ArthurBondar/Tow-Camera-Public/Documentation/Instructions/Images/assembly 2.PNG

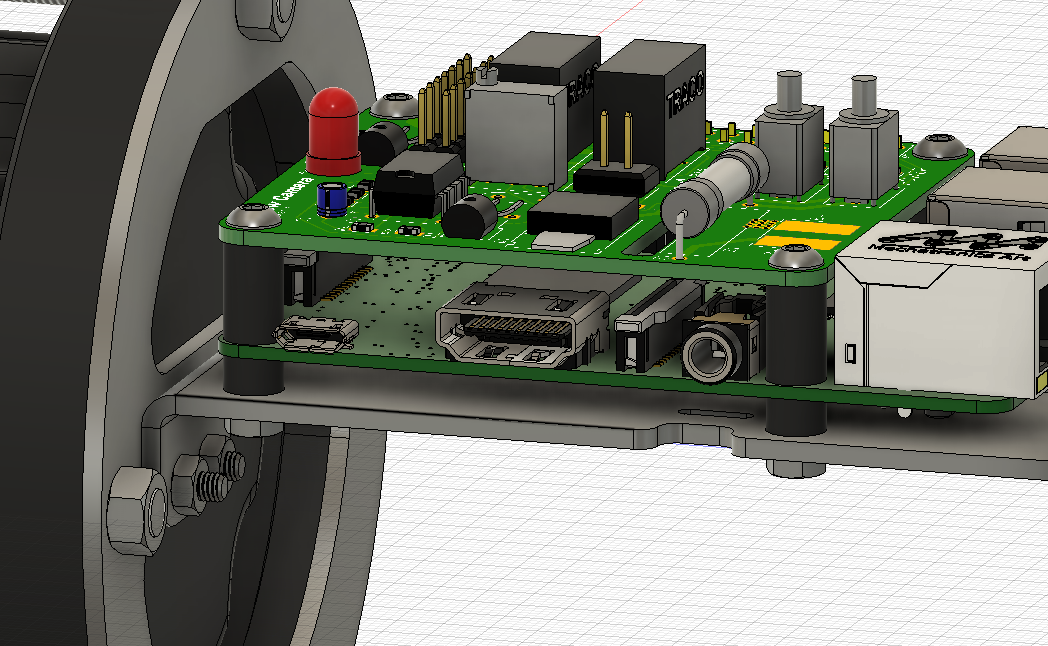
Documentation/Instructions/Images/assembly 2.PNG
