ArthurBondar/Tow-Camera-Public/Documentation/Instructions/Images/dissasembly 2.PNG

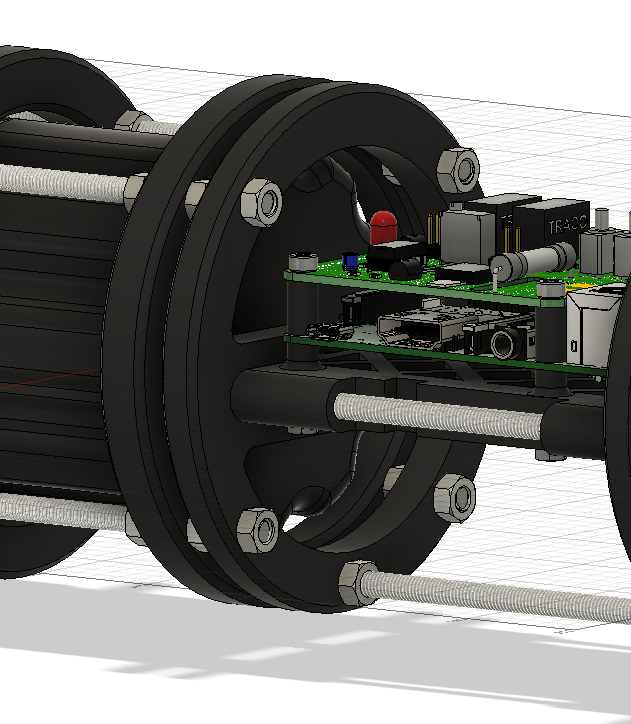
Documentation/Instructions/Images/dissasembly 2.PNG
