ArthurBondar/Tow-Camera-Public/Software/docs/raspbian - How can I prevent my Pi's SD card from getting corrupted so often_ - Raspberry Pi Stack Exchange.pdf

Raspberry Pi Stack Exchange is a question and answer site for users and developers of hardware and software for Raspberry Pi. It only takes a minute to sign up.

Sign up to join this community (https://raspberrypi.stackexchange.com/users/signup?ssrc=hero)

Anybody can ask a question

Anybody can answer

The best answers are voted up and rise to the top

How can I prevent my Pi's SD card from getting corrupted so often? (https://raspberrypi.stackexchange.com/questions/7978/how-can-i-prevent-my-pis-sd-card-from-getting-corrupted-so-often)

Asked 6 years, 11 months ago Active 1 month ago (https://raspberrypi.stackexchange.com/questions/7978/how-can-i-prevent-my-pis-sd-card-from-getting-corrupted-so-often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) Viewed 65k times

48

37

I get an I/O error at boot and then get this 'error': (I am running the latest version of Raspbian)

Entering kdb (current=0xca82ac80, pid 1) due to keyboard entry
kdb> _

And I have seen it before, and was explained that my SD card got corrupted since I did not shutdown correctly. One week later, I didn't deal with this error, until the power flickered on/off thrice and now I can't boot again. It seems like I am re-preparing my SD card ever day!!! I don't like this, not to mention I love my Pi's capabilities. But this 'breakpoint' is driving me crazy! Is there some way I can prevent this or strengthen something so it doesn't happen if the power goes out? Any suggestions? Thanks!

P.S. My zip file was not corrupted and my extraction service is Win32DiskImager

raspbian (https://raspberrypi.stackexchange.com/questions/tagged/raspbian) | sd-card (https://raspberrypi.stackexchange.com/questions/tagged/sd-card) | boot-issues (https://raspberrypi.stackexchange.com/questions/tagged/boot-issues)
edited Jun 16 '13 at 17:28 (https://raspberrypi.stackexchange.com/posts/7978/revisions) | asked Jun 15 '13 at 1:43
user151324 (https://raspberrypi.stackexchange.com/users/7839/user151324)
1,090 | 4 | 13 | 17

2 Is your card on this list (http://elinux.org/RPi_SD_cards) – Butters (https://raspberrypi.stackexchange.com/users/7155/butters) Jun 15 '13 at 2:05

have you ever thought about UPS ? – lenik (https://raspberrypi.stackexchange.com/users/7274/lenik) Jun 15 '13 at 7:29

@lenik Are you saying I should have something like a surge protector? – (https://stackoverflow.com/legal/cookie-policy) user151324 (https://raspberrypi.stackexchange.com/users/7839/user151324) Jun 15 (https://stackoverflow.com/legal/privacy-policy) '13 at 13:53 (https://stackoverflow.com/legal/terms-of-service/public)

By using our site, you acknowledge that you have read and understand our | , (https://raspberrypi.stackexchange.com/users/7839/user151324) | , and
our | .

Cookie P (https://stackoverflow.com/legal/cookie-policy)olicy Privacy (https://raspberrypi.stackexchange.com/users/7839/user151324) Policy (https://stackoverflow.com/legal/privacy-policy) Terms of Service (https://stackoverflow.com/legal/terms-of-service/public)

Because you power off the thing without a proper shutdown? – jippie (https://raspberrypi.stackexchange.com/users/7987/jippie) Jun 15 '13 at 15:13

2

–

@coding_corgi more likely something with a battery inside, that provides power for 5-10 minutes after the power outage, that allows you to ignore short power flicks and gives you time to shutdown (automatically?) your computer when power goes down for a long time. It's called "Uninterruptable Power Supply" or UPS for short. lenik (https://raspberrypi.stackexchange.com/users/7274/lenik) Jun 15 '13 at 23:52

11 Answers | Active (https://raspberrypi.stackexchange.com/questions/7978/how-can-i-prevent-my-pis-sd-card-from-getting-corrupted-so-often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) | Oldest (https://raspberrypi.stackexchange.com/questions/7978/how-can-i-prevent-my-pis-sd-card-from-getting-corrupted-so-often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)

49

+50

I'm not going to write about checking your HW and compatible SD card lists, because you most probably have already checked all these. What I'm about to write is the permanent solution, that allows to nip the problem in the bud, and permanently fix the issue.

If you don't want your SD card to get broken when you flip the power switch, you have to use it in a read-only mode. If there's nothing being written to your SD card, it won't get damaged no matter what you do.

Obvious (but non-working) solution would be an attempt to flip "read-only" switch on the side of the SD card, unfortunately this does not work because the schematics shows this switch is routed nowhere and its position is generally ignored.

Another, more subtle (but working) approach would be modifying your | to mount all
your partitions read-only. The drawback of this approach is your logs have to be written somewhere else (USB stick, RAM drive?) and in case of RAM drive the logs won't persist during reboot. To do this:

/etc/fstab

1. Copy an RPi image to your SD card using any method you like.
2. Boot from SD and | will start automatically. Do not "Expand filesystem", just
set up your time zone and international settings.
| raspi-config
3. Run | , press 'p' to print the current partition table. Then enter the
following commands:

sudo fdisk /dev/mmcblk0

n | Create a new partition
[enter] Make a primary partition
[enter] Use the default number
[#] 1 greater than the end of mmcblk0p2 [enter] Expand to the end of the SD card
w | Write the partition table and exit
4. Edit | /etc/fstab | . It should look something like the following:
proc | /proc | proc | defaults 0 0
/dev/mmcblk0p1 /boot | vfat | ro | 0 0
/dev/mmcblk0p2 / | ext4 | ro | 0 0
/dev/mmcblk0p3 /home | ext4 | defaults,errors=remount-ro 0 1
none | /var/run ramfs | size=1M 0 0
none | /var/log ramfs | size=1M 0 0
5. Run | sudo partprobe | to recognize the new partition.
6. Format your new partition with | sudo mkfs --type ext4 /dev/mmcblk0p3 | .
7. Reboot.

If for some reason you need to make changes to your system, you can remount the read-only partitions with write access:

Votes (https://raspberrypi.stackexchange.com/questions/7978/how-can-i-prevent-my-pis-sd-card-from-getting-corrupted-so-often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)

sudo mount -o remount,rw /dev/mmcblk0p2

edited Mar 19 '14 at 22:33 (https://raspberrypi.stackexchange.com/posts/8038/revisions) Brad (https://raspberrypi.stackexchange.com/users/3320/brad)
107 4

answered Jun 19 '13 at 0:57 lenik (https://raspberrypi.stackexchange.com/users/7274/lenik)
11.1k | 1 | 27 | 36

Wait, I can't write to my SD card if I do this? Or only at boot? – user151324 (https://raspberrypi.stackexchange.com/users/7839/user151324) Jun 19 '13 at 2:02

1 @coding_corgi This should stop writing to the SD card entirely. – apnorton (https://raspberrypi.stackexchange.com/users/7482/apnorton) Jun 19 '13 at 2:04

–

why do you need to write to your SD card? writing to SD + power down = FS corruption, you may use USB stick or create a separate partition on SD card if you need to save some data. in this case at least your system will get up and running, and then you may check your data for possible corruption. lenik (https://raspberrypi.stackexchange.com/users/7274/lenik) Jun 19 '13 at 2:06

–

@anorton this stops write access to the first two partitions on SD card, but nobody says you cannot create another partition, or use different media to save the data. for example, read-only RasPi writing data over the network -- could be a very reliable solution. lenik (https://raspberrypi.stackexchange.com/users/7274/lenik) Jun 19 '13 at 2:07

1

–

I write to my SD card video data from raspi cam and it died so many times! Not once did I have any issues with booting up, pulled wire out or system crash. Read only is good for production when you plug and play. This problem should not happen during development any way- I suspect even read only will mess up his data because something is happening at a higher level than kernel can handle. Piotr Kula (https://raspberrypi.stackexchange.com/users/894/piotr-kula) Jun 19 '13 at 9:26

4

### Edit

The IPE home page seems to be no more accessible.

It should not be used since it seems not to be maintained anymore.

For the record, here is a link to the old IPE homepage at web.archive.org (http://web.archive.org/web/20131115094944/http://nutcom.hu/?page_id=108)

### Old post

Depending of what you use your RPi for, you may be insterested in IPE, which is a "blackout-proof flavour of Raspbian".

I plan to use it to boot my RPi. If I need data to be writen, I will use an USB drive that I'll mount readonly (I prefer my SD to be safe and corrupt an USB drive than having to repair my SD)

See the IPE homepage (http://nutcom.hu/?page_id=108)

As indicated there, "Also, use “ipe-rw” and “ipe-ro” to switch the root file system to writeable or read-only mode."

edited Apr 20 at 12:17 (https://raspberrypi.stackexchange.com/posts/12232/revisions) | answered Dec 11 '13 at 14:45
lauhub (https://raspberrypi.stackexchange.com/users/3136/lauhub)
314 | 2 | 6

This IPE homepage (http://nutcom.hu/?page_id=108) brings to an empty page. – Danilo Schembri (https://raspberrypi.stackexchange.com/users/66762/danilo-schembri) Apr 19 at 19:09

–

Thanks for the information. Unfortunately it seems to be not maintained anymore. I edited my answer
By using our saccordingly ite, you acknolauhub wledgeApr (https://raspberrypi.stackexchange.com/users/3136/lauhub) 20 at 12:18 that you have read and understand our | , | , and

2

I have overcome this issue by using a USB flash drive for my main partitions.

1. Restore raspbian image to a USB drive
2. Format an SD card to fat
3. Copy contents of fat partition from USB drive onto SD card
4. Modify config.txt on sd card to boot from /dev/sda

Essentially the rpi will still boot from the SD card, but will use the USB drive for the os and read/writes.

answered Feb 19 '14 at 5:51 Ace (https://raspberrypi.stackexchange.com/users/9024/ace)
151 | 1 | 5

2

I'm using the | a specially designed UPS for the Raspberry Pi and never have had
such problems.

UPS Pico (http://www.pimodulescart.com/shop/item.aspx?itemid=5)

edited May 25 '15 at 16:23 (https://raspberrypi.stackexchange.com/posts/31836/revisions) Ghanima (https://raspberrypi.stackexchange.com/users/19949/ghanima) ♦
14.7k | 13 | 51 | 97

answered May 23 '15 at 12:40 Alexander (https://raspberrypi.stackexchange.com/users/31162/alexander)
61 1

1

please ensure your RPi is running on the default speeds (i.e. CPU at 700mhz). personally, i encountered storage corruptions with various SD cards - but only when running over the clock. unfortunately, some distributions (images) come with questionable settings in config.txt. (http://elinux.org/RPiconfig)

answered Jun 17 '13 at 20:42

I have not overclocked my CPU, thanks though – user151324 (https://raspberrypi.stackexchange.com/users/7839/user151324) Jun 17 '13 at 22:00

try another RPi to exclude the chance that yours is somehow flawed or even broken – jitter (https://raspberrypi.stackexchange.com/users/8018/jitter) Jun 18 '13 at

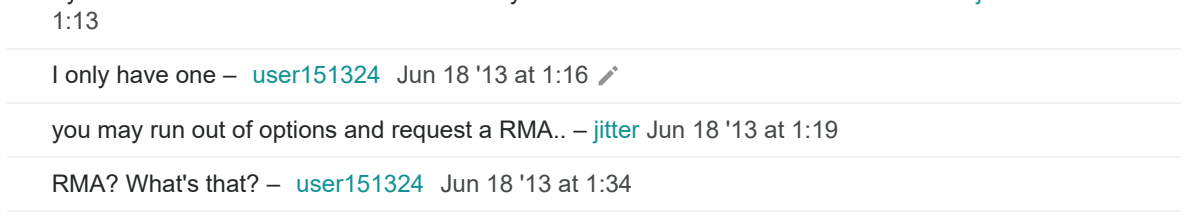
[picture p16: figure]

I only have one – user151324 (https://raspberrypi.stackexchange.com/users/7839/user151324) Jun 18 '13 at 1:16

you may run out of options and request a RMA.. – jitter (https://raspberrypi.stackexchange.com/users/8018/jitter) Jun 18 '13 at 1:19

RMA? What's that? – user151324 (https://raspberrypi.stackexchange.com/users/7839/user151324) Jun 18 '13 at 1:34

1

Just to cover all ground, also check if your power supply is good enough. try other charger or plug the RPI to a PC USB port to test it. Remember that the recommended RPI supply is about 700mA, but some weak chargers might not sustain this at stable levels.

I had a router that start to act crazy for some days, then went ok, then again went crazy and

later fine again ... i found that the power supply was outputting changing voltage (3V to 5.5V) on the time the router was crazy. Replaced that supply with a new one (https://stackoverflow.com/legal/cookie-policy) all is fine. So try (https://stackoverflow.com/legal/privacy-policy) replace the power (https://stackoverflow.com/legal/terms-of-service/public) supply and measure the output voltage.

Finally, turn off the RPI by shutting down the OS and only unplug the RPI when you got only one red led. the RPI is not really shutdown if you have other than one red led. Also, try to avoid disconnect the rpi by removing the power supply from the plug, it's better to remove the power from the RPI and only after remote the power supply from the plug.

answered Jun 21 '13 at 13:44 higuita (https://raspberrypi.stackexchange.com/users/7502/higuita)
624 | 5 | 6

No, I have a steady 5.1V @ 2100 A, and I always properly shutdown – user151324 (https://raspberrypi.stackexchange.com/users/7839/user151324) Jun 21 '13 at 14:13

1

If your Raspberry Pi is frozen then you can not shutdown correctly, then this helps. I was broke my few SD cards before knew this:

Hold down both Alt+PrintScreen, and while holding those keys, hit the following keys in sequence, one at a time, with a few seconds pause between them.

Alt | + | PrintScreen | + | R | E | I | S | U | O

or

Alt | + | PrintScreen | + | R | E | I | S | U | B | (reboot)

A handy mnemonic to remember that is, Reboot Even If System Utterly Broken.

Substitute "O" for "B" to shut down the system instead of rebooting (O=off, B=boot).

Source: https://www.raspberrypi.org/forums/viewtopic.php?t=176612#p1126262

answered Sep 13 '19 at 3:53 Almas Dusal (https://raspberrypi.stackexchange.com/users/84204/almas-dusal)
311 | 3 | 3

0

As found on the elinux site. I only selected what applies to your situation but please visit them for more information... (http://elinux.org/R-Pi_Troubleshooting)

If you have problems, check you have latest firmware version with rpi-update (https://github.com/Hexxeh/rpi-update/)
Some SD cards do not work on the R-Pi, so check the list of known SD cards. (http://elinux.org/RPi_VerifiedPeripherals#SD_cards)
If you are having problems setting up your SD card you might want to start by erasing it completely - especially if it has been used elsewhere and still contains data / partitions. It is good to do a FULL (low level) format any way as it can find bad sectors sometimes and add them to an ignore list.
Windows and Mac users can download a formatting tool from the SD Association: https://www.sdcard.org/downloads/formatter_3/
Reformatting cards is also easy to do in a digital camera.
If you are manually preparing your SD card on Linux or Mac OS using the dd command, this operation will completely erase any existing data and partitions. Make sure you write to the whole card (e.g. /dev/sdd) and not to an existing partition (e.g.

If you (https://stackoverflow.com/legal/terms-of-service/public) have an sdcard that doesn't work with latest firmware, head over here. (http://www.raspberrypi.org/phpBB3/viewtopic.php?f=63&t=6093)

Make sure you have a good power supply. Try and unplug everything and see how long it lasts. Plug items back in one by one testing the stability.

If you have followed all those steps then the only possible thing to try is use another SD Card carefully selected from the compatible list. Also make sure to buy original card from a trusted place. Not like ebay china or something.

answered Jun 17 '13 at 15:27 Piotr Kula (https://raspberrypi.stackexchange.com/users/894/piotr-kula)
16.3k | 6 | 57 | 100

–

I used 3 sd cards in the process (all supported) a SanDisk, a Kingston and a Lexar, I am manually setting up my SD card either, I used the Win32DiskImager after trying on Ubuntu and Mac OS X.

not

user151324 (https://raspberrypi.stackexchange.com/users/7839/user151324) Jun 17 '13 at 16:05

–

Its wierd that making your fs read only fixed it. You out of a millions of people has this issue. Maybe you got some rubbish/virus messing up your filesystem. Readonly root is a pain in the ass... wait and see. Piotr Kula (https://raspberrypi.stackexchange.com/users/894/piotr-kula) Jun 24 '13 at 7:40

thanks, something weird is going on, definetly not a virus though... – user151324 (https://raspberrypi.stackexchange.com/users/7839/user151324) Jun 24 '13 at 13:26

0

I have similar problems on a pi from RS Components. This is one of the pis made on China. Another one made in UK from Element 14 never had corruption with the same sdcard and powersupply. Might be some Hardwareflaw with the ra components units. Not sure of that of course, but everything seems to point in that direction.

answered Sep 5 '13 at 19:57 mcobit (https://raspberrypi.stackexchange.com/users/9379/mcobit)
1

0

I've also experienced SD Failures with my PI, sometimes 5 days in a row, sometimes it works for a month.

The only way I could get it to run reliable for more than a year now is to Boot from a USB stick. This way you don't use your SD card (only at boot) und just need about 500mb sd card (cheap) and a USB Stick.

answered Dec 11 '13 at 15:15 Gotschi (https://raspberrypi.stackexchange.com/users/10526/gotschi)
553 | 1 | 6 | 16

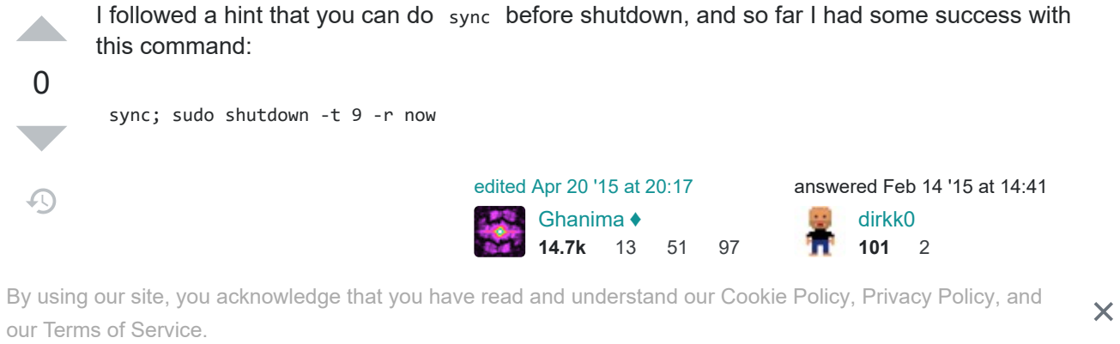
[picture p17: figure]
this command:; sync; sync; sudo shutdown -t 9 -r now; edited Apr 20 '15 at 20:17 Ghanima ♦; answered Feb 14 '15 at 14:41 dirkk0 101 2

I followed a hint that you can do | before shutdown, and so far I had some success with

Are you (https://stackoverflow.com/legal/terms-of-service/public) still having problem with Raspberry using above solution? – CuriousMind (https://raspberrypi.stackexchange.com/users/28254/curiousmind) Mar 22 '15 at 12:40

–

I didn't have any problem anymore - but I do admit that I tend to rather leaver the pi on, instead of shutting it down. But my guess is that I shit it down well over fifty times with the above line, and it didn't fail once since then. So from that statistic - it works. dirkk0 (https://raspberrypi.stackexchange.com/users/27013/dirkk0) Mar 23 '15 at 14:04

–

I don't think this will fix the issue. When you run a controlled shutdown, no damage should happen to your sd card by design. Corruption seems to happen mostly in cases in which the device is simply
unplugged (or power outage occurs) which is unrelated to your | or | commands unless
you run | immediately before the (unexpected!) unplugging which seems unfeasible.
sync | shutdown
sync | | nhee (https://raspberrypi.stackexchange.com/users/27563/nhee) Oct
30 '15 at 4:05

. Earn 10 reputation in order to answer this question. The reputation requirement helps protect this question from spam and non-answer activity.

Highly active question (https://raspberrypi.stackexchange.com/help/privileges/protect-questions)
