ArthurBondar/Tow-Camera-Public/Software/docs/Stopping SD Card Corruption on Raspberry Pi’s Raspbian – IdeaHeap.pdf

The following are instructions for minimizing SD card writes for Raspberry Pi’s “Raspbian” Distribution.
If you’re like me, you’ve run into a corrupted SD card too many times to not become hell-bent on making it never happen again. I have the following setup, and it seems to be working well for me.

The biggest oender for Filesystem writes on any linux system is logging. If you are like me, you don’t really look at /var/log after a recycle anyways. This area, and /var/run, a location where lock les, pid les and other “stu” shows up, are the most common areas for mess-ups. Take a look at your blinking FS light on the board. Our goal is to make that light stay o as long as possible.
Set up tmpfs mounts for worst offenders. Do other tweaks.

Linux has with it the concept of an in-memory lesystem. If you write les to an in-memory lesystem, they will only exist in memory, and never be written to disk. There are two common mount types you can use here: ramfs, which will continue to eat memory until your system locks up (bad), and tmpfs, which sets a hard upper limit on mount size, but will swap things out if memory gets low (bad for raspberry pi, you will probably be hard stopping your device if it is low on memory).

We will rst solve the usual corruption culprit and then move on to making sure we are covered when our programs decide to blow up. (http://www.ideaheap.com/)

The following two lines should be added to /etc/fstab:

none | /var/run | tmpfs | size=1M,noatime (http://ideaheap.com/projects/) | 00
none | /var/log | tmpfs | size=1M,noatime | 00
(http://ideaheap.com) | (http://ideaheap.com/2013/) | (http://ideaheap.com/2013/07/)

# STOPPING SD CARD CORRUPTION ON RASPBERRY PI’S RASPBIAN

Posted On July 31, 2013 (http://ideaheap.com/2013/07/stopping-sd-card-corruption-on-a-raspberry-pi/)
By Nicholas Wertzberger (http://ideaheap.com/author/admin/)
Home (http://ideaheap.com/) | 2013 (http://ideaheap.com/2013/) | July (http://ideaheap.com/2013/07/) | Stopping SD Card Corruption on Raspberry Pi’s
Raspbian

# I D E AHE A P (HT T P ://I D E AHE A P. COM/) (http://ideaheap.com/)

P E R C O L A T I N G I N S I G H T F R O M O M A H A , N E

H O M E ( H T T P : // W W W. I D E A H E A P. C O M ) (http://www.ideaheap.com/) A B O U T N I C K ( H T T P : // I D E A H E A P. C O M / A B O U T- I D E A H E A P / ) (http://ideaheap.com/about-ideaheap/)

P R O J E C T S ( H T T P : // I D E A H E A P. C O M / P R O J E C T S / ) (http://ideaheap.com/projects/)

UPDATE (unveried): I have been told that /var/run is now a symlink to a tmpfs lesystem, anyways, so you may not need to add /var/run anymore, and adding it may cause issues.

There’s more, however. By default, linux also records when a le was last accessed. That means that every time you read a le, the SD card is written to. That is no good! Luckily, you can specify the “noatime” option to disable this lesystem feature. I use this ag generously.

Also, for good measure, i set /boot to read-only. There’s really no need to regularly update this, and you can come back here and change it to “defaults” and reboot when you need to do something.

After this, /etc/fstab should look as follows:

UPDATE (unveried): I have been told that /var/run is now a symlink to a tmpfs lesystem, anyways, so you may not need to add /var/run anymore, and adding it may cause issues.

Go ahead and reboot now to see things come up. Check the Filesystem light on your raspberry pi after it’s fully booted. You should see no blinking at all.

# Disable swapping

As a note, since i have done the changes above, i have not corrupted an SD card. I’m not saying I’ve tried very hard, but it is much better, even with power plug pulls, which i tried a few of after doing these changes.

One protection against SD card corruption is an optional, but potentially “I’m glad i did that” change to disable swapping.

The raspberry pi uses dphys-swaple to control swapping. It dynamically creates a swap partition based on the available RAM. This tool needs to be used to turn o swap, and then needs to be removed from startup.

Run the following commands to disable swapping forever on your system:

After doing this, call free -m in order to see your memory usage:

If you reboot, and run a free -m again, you should still see swap at 0. Now we don’t have to worry about tmpfs lesystems swapping out to hard disk!

# Housekeeping!

As you go on and install other tools and frameworks on your raspberry pi (like ROS), you need to be aware of where caches and logles are written to. If, for example, you use ROS, the nodes will, by default, log to ~/.ros/log/. For these sorts of things, and for ROS in particular, point these logs to a folder on /dev/shm. This mount is created by default on linux boxes, and is a tmpfs lesystem that is globally writable by default. Mine has 88 MB.
For example, pointing ROS logs to this le could be done by adding the following to your .bashrc:

If you feel like creating more mounts, feel free, but I have run into ownership issues that required having another script on startup that had to be run as root to chown directories to their (http://ideaheap.com/projects/) proper owners.

proc | /proc | proc | defaults | 0 | 0
/dev/mmcblk0p1 /boot | vfat | ro,noatime | 0 | 2
/dev/mmcblk0p2 / | ext4 | defaults,noatime | 0 | 1
none | /var/run | tmpfs | size=1M,noatime | 0 | 0
none | /var/log | tmpfs | size=1M,noatime | 0 | 0

sudo dphys-swapfile swapoff
sudo dphys-swapfile uninstall
sudo update-rc.d dphys-swapfile remove

pi@raspberrypi ~ $ free -m
| total | used | free | shared | buffers | cached
Mem: | 438 | 59 | 378 | 0 | 9 | 27
-/+ buffers/cache: | 22 | 416
Swap: | 0 | 0 | 0

export ROS_LOG_DIR=/dev/shm/rosLogs (http://www.ideaheap.com/)

H O M E ( H T T P : // W W W. I D E A H E A P. C O M ) (http://www.ideaheap.com/) A B O U T N I C K ( H T T P : // I D E A H E A P. C O M / A B O U T- I D E A H E A P / ) (http://ideaheap.com/about-ideaheap/)

# Getting to 100%

The only way to fully protect against SD card corruption is to mount your root lesystem as readonly. For me, this was too much of a usability issue. I am editing les and installing new packages too often for this to be feasible. The steps listed above should, however, cover you 98% of the time. Try not to pull power while you’re editing les or installing new packages on your device, and you should be ne. Still make backup images of your SD card every once in a while! This is a best practice no matter what!

Happy Hacking!

CATEGORY: RASPBERRY PI (HTTP://IDEAHEAP.COM/CATEGORY/RASPBERRY-PI/)

## 32 THOUGHTS ON “STOPPING SD CARD CORRUPTION ON RASPBERRY PI’S RASPBIAN”

Andy
October 1, 2013 at 8:52 AM (http://ideaheap.com/2013/07/stopping-sd-card-corruption-on-a-raspberry-pi/#comment-218)
Can it be done some like readonly fs as default mode, but some script lauching enables write mode, then another script back fs to read only? or maybe adding user which have write permissions?

Reply (http://ideaheap.com/2013/07/stopping-sd-card-corruption-on-a-raspberry-pi/?replytocom=218#respond)

Adrian
November 3, 2013 at 3:11 PM (http://ideaheap.com/2013/07/stopping-sd-card-corruption-on-a-raspberry-pi/#comment-246)
Thank you verry much for posting this.
I have a lot of trouble with my Raspberry, trying to make it not ruin my card once a few days, so i came across this post; it will surely prove useful.

However, there’s something i discovered while playing with my Rasp, trying to see how to make it stable. Maybe it will prove useful to others. It seems that Arch Linux is far more stable than Raspbian, regarding SD card corruption. Without your settings made, i pulled the power plug several times with no problems. I started to read directory tree “dir -Rlh /” and pulled the plug while still listing, still no problems. I started to write a le “cat /dev/random > /root/le” and then pulled the plug and still no problems found. After restart, Arch Linux would still give me SSH and let me login.

So i would say that this distribution of Linux is much better, at least from this point of vue, than Debian.

Cheers

Reply (http://ideaheap.com/2013/07/stopping-sd-card-corruption-on-a-raspberry-pi/?replytocom=246#respond)

jeanrochblais
December 2, 2013 at 9:03 PM (http://ideaheap.com/2013/07/stopping-sd-card-corruption-on-a-raspberry-pi/#comment-366)
my solution, mount /root on (http://www.ideaheap.com/) a hard drive and mount SD read only… only used for boot from nowon ! (http://ideaheap.com/about-ideaheap/)

Reply (http://ideaheap.com/2013/07/stopping-sd-card-corruption-on-a-raspberry-pi/?replytocom=366#respond) (http://ideaheap.com/2013/07/stopping-sd-card-corruption-on-a-raspberry-pi/?replytocom=366#respond)

Using the Power of the Markov Assumption (http://ideaheap.com/2012/11/using-the-power-of-themarkov-property/)

- (http://ideaheap.com/2012/11/using-the-power-of-the-markov-property/)

Nightmare before Christmas Code (http://ideaheap.com/2014/02/nightmare-beforechristmas-code/)

- (http://ideaheap.com/2014/02/nightmare-before-christmas-code/)

H O M E ( H T T P : // W W W. I D E A H E A P. C O M ) (http://www.ideaheap.com/) A B O U T N I C K ( H T T P : // I D E A H E A P. C O M / A B O U T- I D E A H E A P / ) (http://ideaheap.com/about-ideaheap/)

A L
January 7, 2015 at 2:39 PM (http://ideaheap.com/2013/07/stopping-sd-card-corruption-on-a-raspberry-pi/#comment-1145043)
Or move lesystem to USB 3.0 stick drive and boot from SD card. Have been somewhat every weekday last 3 months powering o (connected to my laptop docking station) 2-3 times a day “violently” but no problems so far! Now I have started to like that installation as it has proven its stability. I think I’ll use Raspberry Pi only from USB stick lesystem even it takes one precious USB port.

Reply (http://ideaheap.com/2013/07/stopping-sd-card-corruption-on-a-raspberry-pi/?replytocom=1145043#respond) (http://ideaheap.com/2013/07/stopping-sd-card-corruption-on-a-raspberry-pi/?replytocom=1145043)

Cédric
July 24, 2015 at 11:08 AM (http://ideaheap.com/2013/07/stopping-sd-card-corruption-on-a-raspberry-pi/#comment-1200609)
Thanks for the tip but I’m done with Raspbian.
Even with a clean shutdown, the card is corrupted almost every time.
I never encountered this issue with Openelec and Minibian, even with several power failures (and I’ve tested with the same SD to make sure it what not faulty).
So, for me, it is really related to Raspbian.

Reply (http://ideaheap.com/2013/07/stopping-sd-card-corruption-on-a-raspberry-pi/?replytocom=1200609#respond) (http://ideaheap.com/2013/07/stopping-sd-card-corruption-on-a-raspberry-pi/?replytocom=1200609)

Pingback: IT Cave | Experiencia montando una web sobre una Raspberry Pi (http://it-cave.com/experiencia-montando-una-web-
sobre-una-raspberry-pi/) (http://it-cave.com/experiencia-montando-una-web-sobre-una-raspberry-pi/)

ds00424
January 2, 2014 at 2:35 PM (http://ideaheap.com/2013/07/stopping-sd-card-corruption-on-a-raspberry-pi/#comment-459)
Thanks for the info.

As suggested, i moved /var/log to a 1M ramdrive. However, I found that the /var/log gets used up in about a week (on my system) due to various messages. Auth.log was the largest due to a 5 min cron using sudo to reports some stats to a central server.

Is there any recommended maintenance of /var/log directory to stop it from getting to 100% used?

I guess I could have a monitor script run every hour to check the usage and zero a few les (auth.log, syslog, messages) when nearing the limit. But that seems problematic.

Thanks.

Reply (http://ideaheap.com/2013/07/stopping-sd-card-corruption-on-a-raspberry-pi/?replytocom=459#respond)

admin
February 1, 2014 at 8:20 AM (http://ideaheap.com/2013/07/stopping-sd-card-corruption-on-a-raspberry-pi/#comment-545)
I handle this sort of problem by either conguring it, if possible, or by throwing a cron job together that truncates the le after a period of time. “echo > /var/log/auth.log” would work.

In your case, the “logrotate” tool is probably going to be the right solution. “man logrotate” for more info.

Reply (http://ideaheap.com/2013/07/stopping-sd-card-corruption-on-a-raspberry-pi/?replytocom=545#respond) (http://ideaheap.com/2013/07/stopping-sd-card-corruption-on-a-raspberry-pi/?replytocom=545#respond)

Pingback: Problemi con il Raspberry Pi (http://www.gaspartorriero.it/2014/01/problemi-con-il-raspberry-pi/)

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

ZucOs
January 28, 2014 at 2:02 PM (http://ideaheap.com/2013/07/stopping-sd-card-corruption-on-a-raspberry-pi/#comment-540)
Thankx for the tips. Just one problem. With this line:

none /var/run tmpfs size=1M,noatime 00

My wireless keyboard and mouse stop working. If I comment that line in fstab they will work again. Do you have any clue how to solve this?

Reply (http://ideaheap.com/2013/07/stopping-sd-card-corruption-on-a-raspberry-pi/?replytocom=540#respond)

John
March 14, 2014 at 2:06 PM (http://ideaheap.com/2013/07/stopping-sd-card-corruption-on-a-raspberry-pi/#comment-81941)
Same issue here.
none /var/run tmpfs size=1M,native 00
This line deactivates my wireless mouse and keyboard.
Any solution/idea how to solve this?

Reply (http://ideaheap.com/2013/07/stopping-sd-card-corruption-on-a-raspberry-pi/?replytocom=81941#respond) (http://ideaheap.com/2013/07/stopping-sd-card-corruption-on-a-raspberry-pi/?replytocom=81941#respond)

lsx49745
March 13, 2014 at 8:39 PM (http://ideaheap.com/2013/07/stopping-sd-card-corruption-on-a-raspberry-pi/#comment-73818)
This article is very, very bad advice.
Disabling swapping: Just don’t do it. The device is swapping for a reason.
Disabling swapping makes the device slow as hell.
It is already slow as hell, but after disabling swapping it is nearly impossible to work with it.

9 out 10 SSH attempts result in ‘Connection timed out’ or ‘timed out while waiting to read’ just because it is completely stuck.

Why would you store log les in memory any way?
The device is already short in memory.

Just buy a decent SD card and you will likely never experience problems.
I use the cheapest SD card I could nd and I pull the power cord regularly and it has never caused any problem for at least 3 months now.

B.T.W.: most corruption problems arise from overclocking.
Don’t do that either.

Reply (http://ideaheap.com/2013/07/stopping-sd-card-corruption-on-a-raspberry-pi/?replytocom=73818#respond)

admin
March 22, 2014 at 11:13 AM (http://ideaheap.com/2013/07/stopping-sd-card-corruption-on-a-raspberry-pi/#comment-122579)
Hello,

1: Swapping only occurs of you run out of RAM.
2: By Disabling it, I am saying “don’t even try to save me if I’m out of ram”. If you’re swapping, you’re already going to be “slow as hell”. (http://www.ideaheap.com/)
3: Your failed SSH attempts are likely linked to this complete exhaustion of device memory. When linux runs out of memory, it is usually congured to start killing processes, so I would suspect that your new SSH connection is being killed over and over again. (http://ideaheap.com/projects/) check /var/log/errors.log to see if you can see that after you
successfully log in. |
H O M E ( H T T P : // W W W. I D E A H E A P. C O M ) (http://www.ideaheap.com/) | A B O U T N I C K ( H T T P : // I D E A H E A P. C O M / A B O U T- I D E A H E A P / ) (http://ideaheap.com/about-ideaheap/)

4: Our denitions of “Short on memory” may be dierent. By default, your device already has an 80 MB in-memory mount in /dev/shm, by the way. It won’t actually “lock in” that memory until you actually use it. If i tie up all my write-heavy operations using 10M of memory, that is a price i’m willing to pay, as it improves my os ruggedness, and, if you care, the lifetime of the sd card.

5: I’m sure you can get lucky or that certain sd cards won’t have this issue so much, but mine did. If you would rather not buy a new SD card, this is an option. I am not overclocking my pi, either.

Reply (http://ideaheap.com/2013/07/stopping-sd-card-corruption-on-a-raspberry-pi/?replytocom=122579#respond) (http://ideaheap.com/2013/07/stopping-sd-card-corruption-on-a-raspberry-pi/?replytocom=122579#respond)

AzHo
March 23, 2014 at 10:15 AM (http://ideaheap.com/2013/07/stopping-sd-card-corruption-on-a-raspberrypi/#comment-124278)
Linux not only swapping if runs out of ram, linux uses swap in thousand other cases, check the memory management algorithms in the kernel.

Reply (http://ideaheap.com/2013/07/stopping-sd-card-corruption-on-a-raspberry-pi/?replytocom=124278#respond) (http://ideaheap.com/2013/07/stopping-sd-card-corruption-on-a-raspberry-pi/?replytocom=124278#respond)

Nicholas Wertzberger
May 5, 2014 at 8:56 PM (http://ideaheap.com/2013/07/stopping-sd-card-corruption-on-a-raspberrypi/#comment-143748)
“Swap space in Linux is used when the amount of physical memory (RAM) is full. If the system needs more memory resources and the RAM is full, inactive pages in memory are moved to the swap space.” – CentOS (http://www.centos.org/docs/5/html/5.2/Deployment_Guide/s1-swap-what-is.html). You will need to provide proof by contradiction in this case.

Reply (http://ideaheap.com/2013/07/stopping-sd-card-corruption-on-a-raspberry-pi/?replytocom=143748#respond) (http://ideaheap.com/2013/07/stopping-sd-card-corruption-on-a-raspberry-pi/?replytocom=143748#respond)

JC
February 3, 2015 at 7:49 AM (http://ideaheap.com/2013/07/stopping-sd-card-corruption-on-a-raspberrypi/#comment-1169830)
You have no idea what you’re talking about.
Ask yourself: why is it that sysadmins and even extremely limited embedded devices like older phones ran linux WITH swap?

I’m astounded that so many people are following your advice here. Guess what, raspberrypi.org forums are not great source of information.

FYI: I have ran 2 raspberrypi servers since September 2011 WITH swap, WITH logging, torrenting, streaming, backup schedules, and have had NO corruption. I did invest on my sd-cards and do not overclock.

Reply (http://ideaheap.com/2013/07/stopping-sd-card-corruption-on-a-raspberry-pi/?replytocom=1169830#respond) (http://ideaheap.com/2013/07/stopping-sd-card-corruption-on-a-raspberry-pi/?replytocom=1169830)

Nicholas Wertzberger
March 16, 2015 at 7:14 PM (http://ideaheap.com/2013/07/stopping-sd-card-corruption-on-a-raspberry- (http://ideaheap.com/about-ideaheap/)pi/#comment-1177577)
You’re entitled to your opinion. These changes let you run with less write-safe sd cards.

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

Swapping is helpful if you are strapped for memory, but it’s not particularly a good situation once you’re in there. Why is it a bad idea to disable swap or the things that are writing if your goal is to minimize writes out to your sd card? It only makes sense that, if you are trying to minimize the chance of having a catastrophic corrupting power failure, minimize the situations where it occurs.

If you can always guarantee a safe shutdown, you don’t need these steps, but if you’re plugging in and unplugging your raspberry pi all the time without properly shutting it down, these steps make that a LOT less likely to cause lesystem failure (which makes swap kind of useless, eh?)

Reply (http://ideaheap.com/2013/07/stopping-sd-card-corruption-on-a-raspberry-pi/?replytocom=1177577#respond) (http://ideaheap.com/2013/07/stopping-sd-card-corruption-on-a-raspberry-pi/?replytocom=1177577)

K4c (http://vberry.net)
May 17, 2014 at 11:57 AM (http://ideaheap.com/2013/07/stopping-sd-card-corruption-on-a-raspberry-pi/#comment-160293)
In the past i was using voyager linux. This system was working as os for APs, default in ro mode. There were to scripts rw and ro to remount lesystem. Maybe its worth to investigate.

Reply (http://ideaheap.com/2013/07/stopping-sd-card-corruption-on-a-raspberry-pi/?replytocom=160293#respond)

turiakki
October 8, 2014 at 3:45 AM (http://ideaheap.com/2013/07/stopping-sd-card-corruption-on-a-raspberry-pi/#comment-632779)
What about this? SD-cards are relatively cheap and get cheaper as time passes. So, would not one solution be to set up a card for regular use making a backup image maybe like once a week. If the card le system ever gets corrupted, then just format and reinstall from backup image, until one day the card stops working entirely (AFAIK they have a quite limited write/read amount), then get a new one.

Some claim, however, and this most likely is true, that other USB storage devices are much quicker than micro sd. So, there are good reasons for only booting from card and then having everything else on USB. But then you loose one USB port permanently, as you cannot even get the OS running without it.

Reply (http://ideaheap.com/2013/07/stopping-sd-card-corruption-on-a-raspberry-pi/?replytocom=632779#respond)

Andy (http://www.something.com)
January 12, 2015 at 2:34 PM (http://ideaheap.com/2013/07/stopping-sd-card-corruption-on-a-raspberry-pi/#comment-1164265)
For the sake of completeness, you may want to add how to go around apache2’s dependency on a existing log le. It will not start if it has it’s logging directory taken away and it’s one of the main packages of the raspberry pi.

Reply (http://ideaheap.com/2013/07/stopping-sd-card-corruption-on-a-raspberry-pi/?replytocom=1164265#respond)

Nicholas Wertzberger
January 19, 2015 at 8:16 PM (http://ideaheap.com/2013/07/stopping-sd-card-corruption-on-a-raspberry-pi/#comment-1166148)
oh man… so there totally is two ways to handle this…. One of which is “if you don’t want to re-congure apache, you could make an init.d script that generates those folder on boot time BEFORE apache starts up…” just sayin…

Reply (http://ideaheap.com/2013/07/stopping-sd-card-corruption-on-a-raspberry-pi/?replytocom=1166148#respond) (http://ideaheap.com/2013/07/stopping-sd-card-corruption-on-a-raspberry-pi/?replytocom=1166148)

Andy (http://www.something.com)
January 12, 2015 at 2:41 PM (http://ideaheap.com/2013/07/stopping-sd-card-corruption-on-a-raspberry-pi/#comment-1164267) (http://ideaheap.com/projects/)

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

I was running raspbian as a Infra-red remote control device and the line in /etc/fstab that contain /dev/run would not allow me to execute any actions through the IR emitter on the circuit I built. I am using the package “lirc”, I tested this between reboots being the removal/addition of this line the only thing to happen.

Reply (http://ideaheap.com/2013/07/stopping-sd-card-corruption-on-a-raspberry-pi/?replytocom=1164267#respond)

Nicholas Wertzberger
January 19, 2015 at 8:15 PM (http://ideaheap.com/2013/07/stopping-sd-card-corruption-on-a-raspberry-pi/#comment-1166147)
Hey andy, are you discussing /var/run?

Reply (http://ideaheap.com/2013/07/stopping-sd-card-corruption-on-a-raspberry-pi/?replytocom=1166147#respond) (http://ideaheap.com/2013/07/stopping-sd-card-corruption-on-a-raspberry-pi/?replytocom=1166147)

Daniel
January 25, 2015 at 6:48 AM (http://ideaheap.com/2013/07/stopping-sd-card-corruption-on-a-raspberry-pi/#comment-1167645)
Thanks for this article.

But maybe this needs to get an update. /var/run now (raspbian of 2014) is a symlink inside /run which is mounted on a tmpfs anyway. And with adding that /var/run line into fstab, udevd wasn’t able to properly run (besides of other daemons or whatever which may not have told me)

Reply (http://ideaheap.com/2013/07/stopping-sd-card-corruption-on-a-raspberry-pi/?replytocom=1167645#respond)

Nathan
August 12, 2015 at 8:48 PM (http://ideaheap.com/2013/07/stopping-sd-card-corruption-on-a-raspberry-pi/#comment-1204945)
I’m having issues disabling swap. After executing the update-rc.d comment. I am getting these errors. Any help would be greatly appreciated.

update-rc.d: using dependency based boot sequencing
insserv: Script mailip is broken: incomplete LSB comment.
insserv: missing `Provides:’ entry: please add.
insserv: missing `Required-Start:’ entry: please add even if empty. insserv: missing `Required-Stop:’ entry: please add even if empty.
insserv: missing `Default-Start:’ entry: please add even if empty.
insserv: missing `Default-Stop:’ entry: please add even if empty.
insserv: Default-Start undened, assuming empty start runlevel(s) for script `mailip’
insserv: Default-Stop undened, assuming empty stop runlevel(s) for script `mailip’

Reply (http://ideaheap.com/2013/07/stopping-sd-card-corruption-on-a-raspberry-pi/?replytocom=1204945#respond)

Pingback: Overclocking and Stability Testing the Raspberry Pi 2 – Part 1 | Retro Resolution: video gaming
(http://retroresolution.com/2015/11/21/overclocking-and-stability-testing-the-raspberry-pi-2-part-1/)

jihun
February 2, 2016 at 4:15 PM (http://ideaheap.com/2013/07/stopping-sd-card-corruption-on-a-raspberry-pi/#comment-1232987)
thanks! your tips works great!
I made a home router with raspi.
as you say, it goes IO error every weeks.
I follow your advice, now my uptime m (http://www.ideaheap.com/)arks 15 days! (http://ideaheap.com/about-ideaheap/)
great! thank you very much!

Reply (http://ideaheap.com/2013/07/stopping-sd-card-corruption-on-a-raspberry-pi/?replytocom=1232987#respond)

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

John Fro
April 16, 2016 at 10:20 PM (http://ideaheap.com/2013/07/stopping-sd-card-corruption-on-a-raspberry-pi/#comment-1233649)
I followed this general advice on an old RP1 years ago and the multiple units run 24/7 w/ no failures so far. Essentially, nothing gets written to the SD card.

Reply (http://ideaheap.com/2013/07/stopping-sd-card-corruption-on-a-raspberry-pi/?replytocom=1233649#respond)

walter
April 26, 2016 at 4:35 AM (http://ideaheap.com/2013/07/stopping-sd-card-corruption-on-a-raspberry-pi/#comment-1233710)
Linux (and unix) lesystems do not like power outages. Pulling the power just like that is almost guaranteed to corrupt the lesystem. If you are going to pull the power anyway (which you should never do … but you didn’t listen), at least issue the “sync” command a couple of times to write out caches and update the lesystem’s superblock.
If you still get lesystem errors, boot into single user mode and run “fsck” to repair the lesystem. You may also insert the card into another linux computer to fsck it.
Happily running my pi with logging and swap enabled. Swap usage is zero though; I am running a server without X11 so it doesn’t use much memory.

Reply (http://ideaheap.com/2013/07/stopping-sd-card-corruption-on-a-raspberry-pi/?replytocom=1233710#respond)

Nicholas Wertzberger
April 27, 2016 at 9:07 PM (http://ideaheap.com/2013/07/stopping-sd-card-corruption-on-a-raspberry-pi/#comment-1233726)
I only lower the risk of corruption! It’s obviously still possible. In my original use case, the power source was aky (i had an old battery on a mobile source that died every 15 or so minutes).

Reply (http://ideaheap.com/2013/07/stopping-sd-card-corruption-on-a-raspberry-pi/?replytocom=1233726#respond) (http://ideaheap.com/2013/07/stopping-sd-card-corruption-on-a-raspberry-pi/?replytocom=1233726)

Edward Jang
February 15, 2017 at 11:31 PM (http://ideaheap.com/2013/07/stopping-sd-card-corruption-on-a-raspberry-pi/#comment-1235621)
The lxsession log le (~pi/.cache/lxsession/LXDE-pi/run.log) becomes very big…..
I added it in the /etc/fstab to make the le’s max size 10MB..
tmpfs /home/pi/.cache/lxsession/LXDE-pi/ tmpfs size=10M,noatime 0 0
But it doesn’t work…
It continue to become big..
Sure, I can remove the log le in the /etc/crontab job….
But I want to show the log le’s content..
Do you have a good idea?

Reply (http://ideaheap.com/2013/07/stopping-sd-card-corruption-on-a-raspberry-pi/?replytocom=1235621#respond)

Drew Derbyshire
February 8, 2018 at 3:11 PM (http://ideaheap.com/2013/07/stopping-sd-card-corruption-on-a-raspberry-pi/#comment-1237128)
Putting /var/log on a ram disk and thus losing it at every boot (including crashes) is … ill-advised.

Use a reliable disk, and make your power supplies are up to specication. Don’t just assume disk corruption is a way of life.

Reply (http://ideaheap.com/2013/07/stopping-sd-card-corruption-on-a-raspberry-pi/?replytocom=1237128#respond)

LEAVE A REPLY |
H O M E ( H T T P : // W W W. I D E A H E A P. C O M ) (http://www.ideaheap.com/) | A B O U T N I C K ( H T T P : // I D E A H E A P. C O M / A B O U T- I D E A H E A P / ) (http://ideaheap.com/about-ideaheap/)

Your email address will not be published. Required elds are marked *

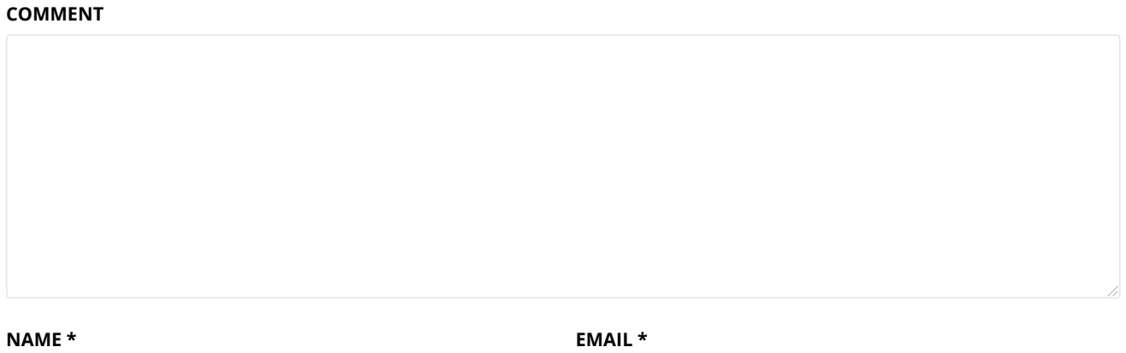
[picture p18: figure]
NAME *; EMAIL *; COMMENT
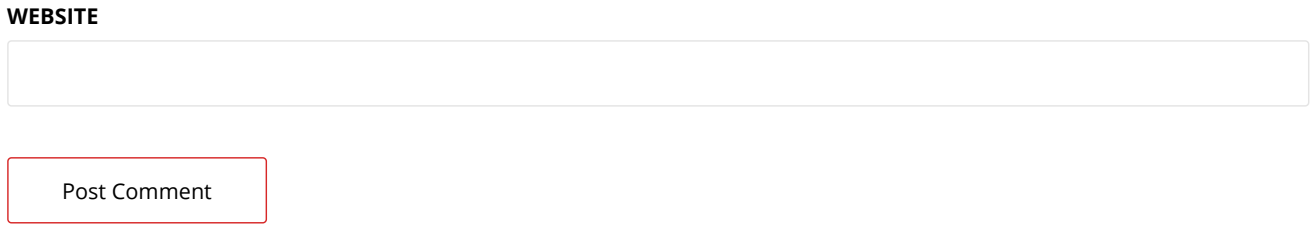
[picture p19: figure]
WEBSITE; Post Comment

This site uses Akismet to reduce spam. Learn how your comment data is processed (https://akismet.com/privacy/).

Copyright © All rights reserved Theme: Innity Blog by Themeinwp (http://themeinwp.com/)
