ArthurBondar/Tow-Camera-Public/Documentation/Images/20200228_183854.jpg

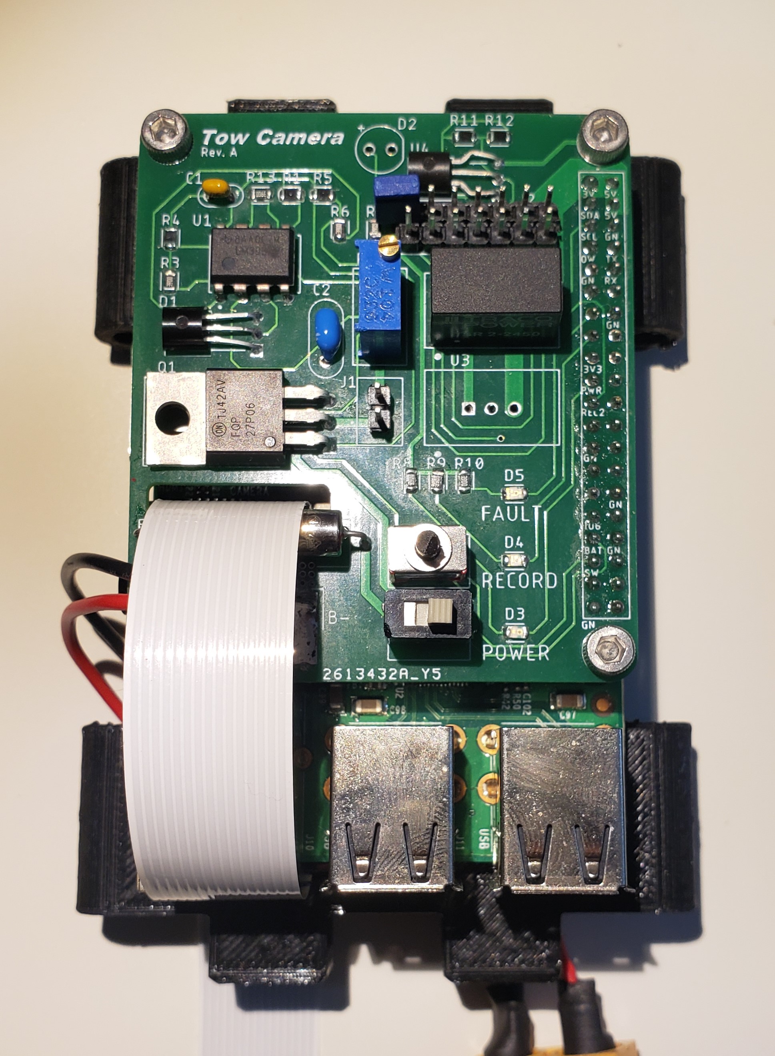
Documentation/Images/20200228_183854.jpg
