ArthurBondar/Tow-Camera-Public/Documentation/Images/20200228_183915.jpg

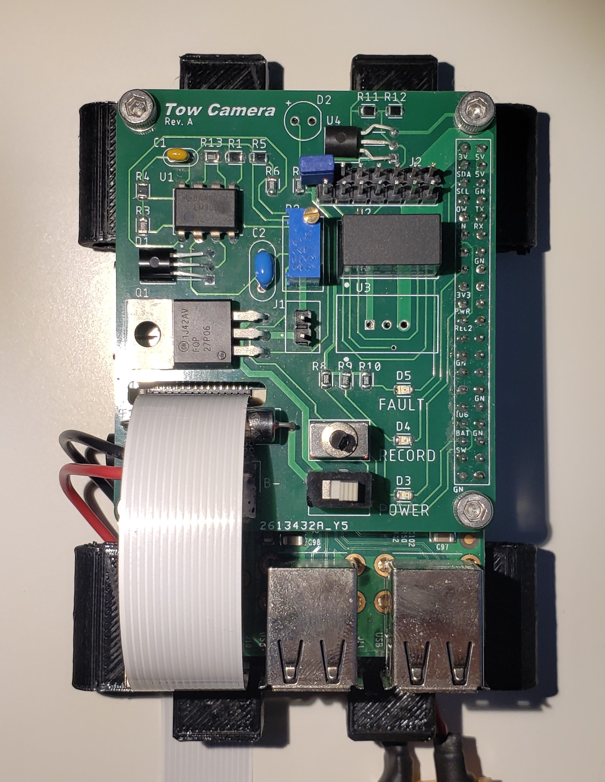
Documentation/Images/20200228_183915.jpg
