ArthurBondar/Tow-Camera-Public/Documentation/Images/20200228_183934 - Copy.jpg

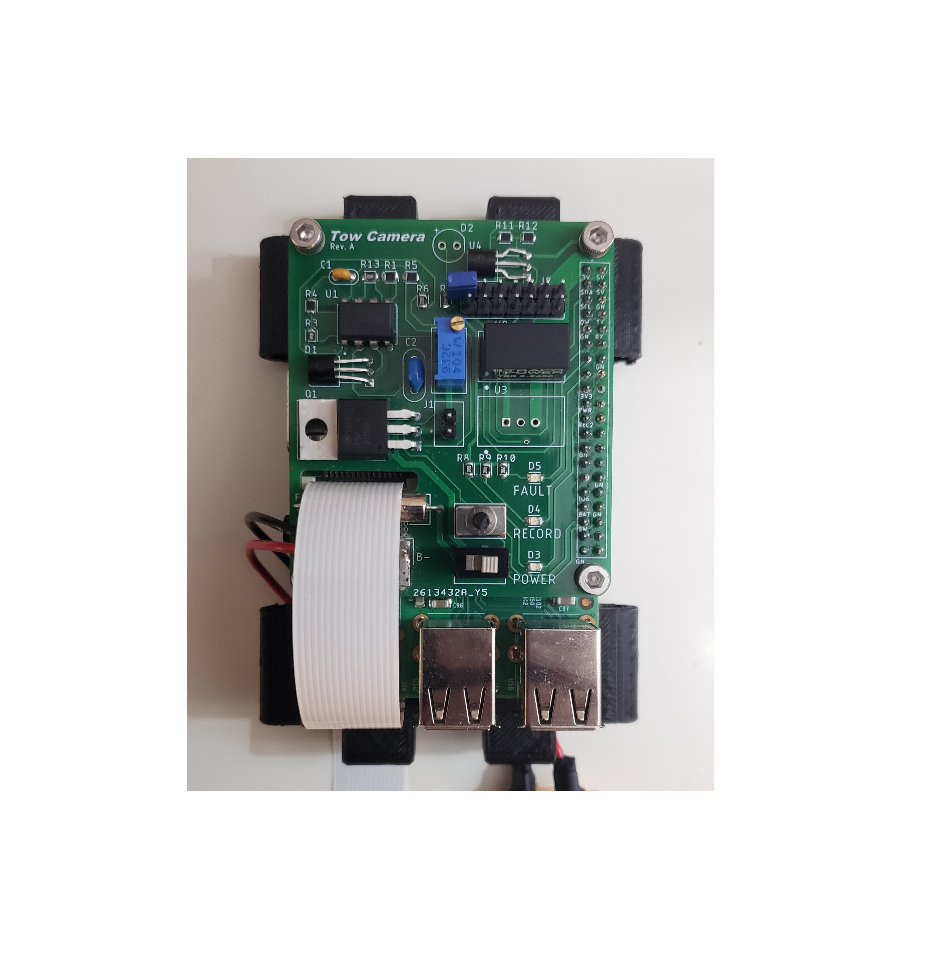
Documentation/Images/20200228_183934 - Copy.jpg
