ArthurBondar/Tow-Camera-Public/Documentation/Images/aluminum_assy.PNG

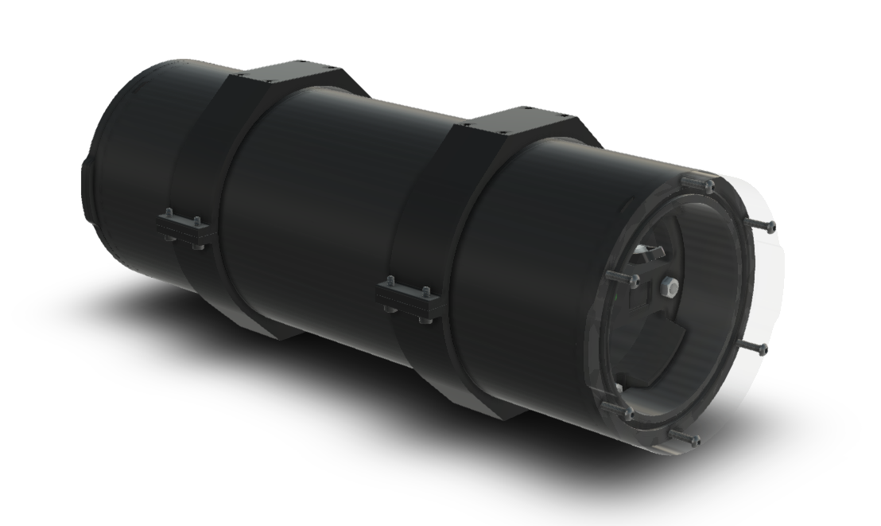
Documentation/Images/aluminum_assy.PNG
