ArthurBondar/Tow-Camera-Public/Documentation/Images/capacity controller.PNG

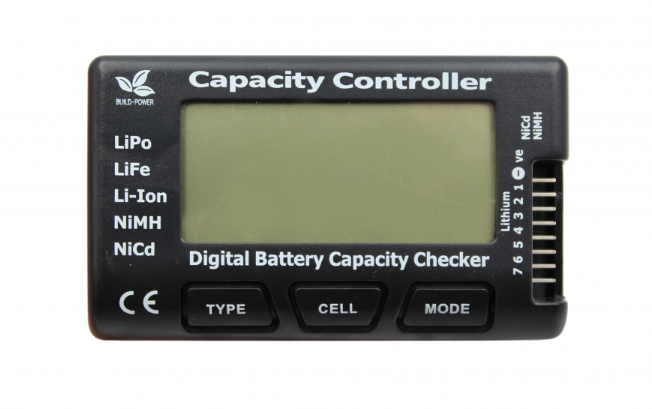
Documentation/Images/capacity controller.PNG
