ArthurBondar/Tow-Camera-Public/Documentation/Images/render1.PNG

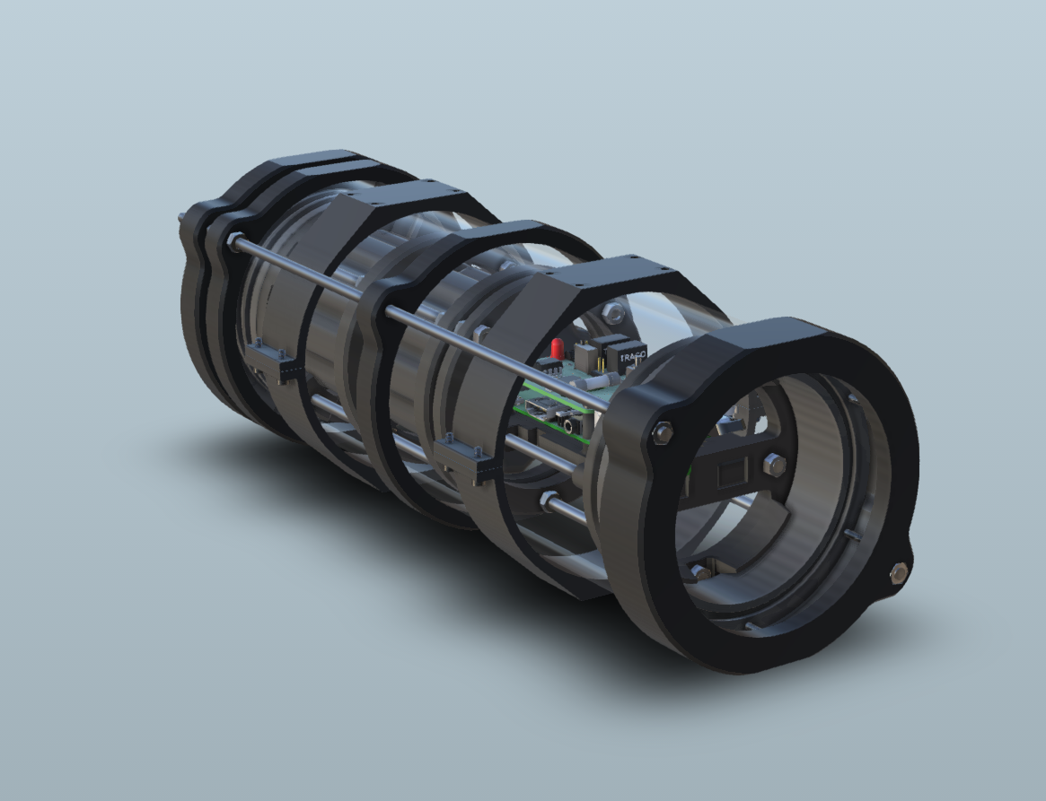
Documentation/Images/render1.PNG
