ArthurBondar/Tow-Camera-Public/PCB/Rev. A/3D Models/RPI3MA+ Dimensions.JPG

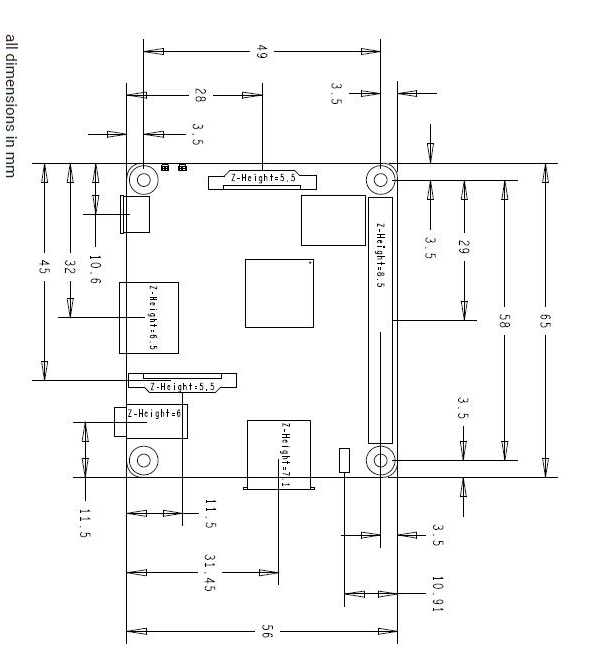
PCB/Rev. A/3D Models/RPI3MA+ Dimensions.JPG
