ArthurBondar/Tow-Camera-Public/Tow Camera v1.2 Render 3.PNG

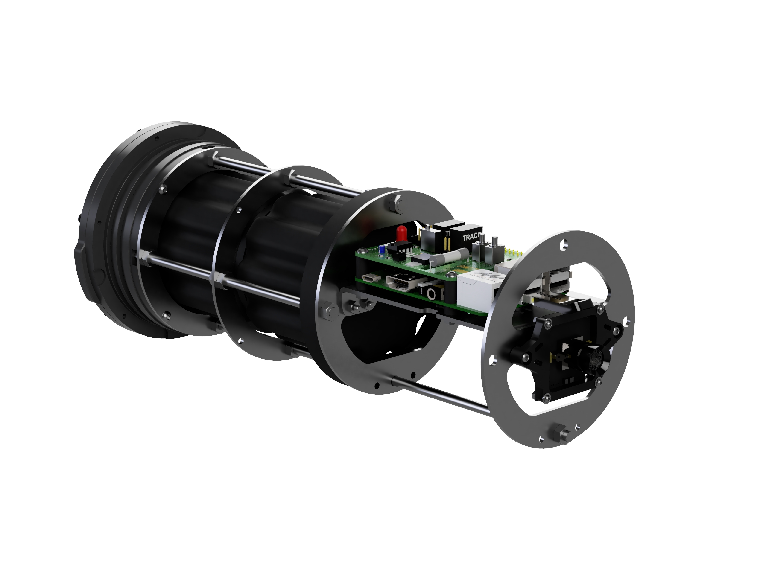
Tow Camera v1.2 Render 3.PNG
