ArthurBondar/Tow-Camera-Public/Documentation/Purchase List Aug 14 2019.xlsx

Sheet: Item List
Tow Camera PCBA Purchase List
2019-12-02
Part Number | Manufactureer | Device | Qty. | Price (CAD) | Extended | Description | Link
Main Components
913-2664 | Raspberry Pi | Pi Camera V2 | 3 | $33.00 | $99.00 | IMX219 Camera Sensor Raspberry Pi Platform Evaluation Expansion Board | https://www.amazon.ca/Raspberry-Pi-Camera-Module-Megapixel/dp/B01ER2SKFS
RASPBERRY PI 3 A+ | Raspberry Pi | Raspberry Pi 3 Model A+ | 2 | $43.10 | $86.20 | BCM2837B0 Raspberry Pi 3 Model A+ - ARM® Cortex®-A53, VideoCore | https://www.digikey.ca/product-detail/en/raspberry-pi/RASPBERRY-PI-3-A/1690-1028-ND/9760878
XT90 | N/A | XT90 Power Connector | 10 | $1.40 | $14.00 | 10 Pairs XT90 Male Female Connector for High-Amp Lipo Batteries | https://www.amazon.ca/Pairs-Female-Connector-High-Amp-Batteries/dp/B076YSDBV5
16GB Class 10 MicroSD | SanDisk | MicroSD module | 1 | $4.00 | $4.00 | Regular microSD module | https://www.amazon.ca/Kingston-16GBCR-Memory-Universal-Black/dp/B079MDKT2D
256GB USB3.0 Flash Drive | SanDisk | USB stick | 1 | $49.00 | $49.00 | USB stick | https://www.amazon.ca/SanDisk-Ultra-Flair-256GB-SDCZ73-256G-G46/dp/B06XG9XP49
 |  |  |  | Total: | $252.20
PCB
TSR 2-2450 | Traco Power | DC/DC Converter | 2 | $17.78 | $35.56 | Linear Regulator Replacement DC DC Converter 1 Output 5V 2A 6.5V - 36V Input | https://www.digikey.ca/product-detail/en/traco-power/TSR-2-2450/1951-2692-ND/9383726
LM4040CIZ-2.5/NOPB | Texas Inst. | Voltage Reference IC | 3 | $1.04 | $3.12 | Shunt Voltage Reference IC ±1.5% TO-92-3 | https://www.digikey.ca/en/products/detail/texas-instruments/LM4040CIZ-2-5-NOPB/182336
LM393AP | Texas Inst. | Comparator | 10 | $0.57 | $5.75 | Comparator Differential CMOS, MOS, Open-Drain, TTL 8-PDIP | https://www.digikey.ca/product-detail/en/texas-instruments/LM393AP/296-6609-5-ND/372797
FQP27P06 | ON Semiconductor | P-Ch. MOSFET | 3 | $2.03 | $6.09 | P-Channel 60V 27A (Tc) 120W (Tc) Through Hole TO-220-3 | https://www.digikey.ca/products/en?keywords=FQP27P06-ND
PV36W104C01B00 | Bourns | Potentiometer | 3 | $2.29 | $6.87 | 100 kOhms 0.5W, 1/2W PC Pins Through Hole Trimmer Potentiometer Cermet 25 Turn Top Adjustment | https://www.digikey.ca/product-detail/en/bourns-inc/PV36W104C01B00/490-2876-ND/666503
PMS9P1B10M2QE | TE Connectivity | Button Switch | 4 | $4.76 | $19.04 | Pushbutton Switch SPST Standard Through Hole | https://www.digikey.ca/products/en?keywords=450-2063-ND
APT2012SURCK | Kingbright | LED red | 10 | $0.45 | $4.48 | Red 630nm LED Indication - Discrete 1.95V 0805 (2012 Metric) | https://www.digikey.ca/products/en?keywords=754-1133-1-ND
LTST-C171KSKT | Lite-On Inc. | LED Yellow | 10 | $0.33 | $3.28 | Yellow 587nm LED Indication - Discrete 2V 0805 (2012 Metric) | https://www.digikey.ca/products/en?keywords=160-1428-1-ND
LTST-C170GKT | Lite-On Inc. | LED green | 10 | $0.33 | $3.28 | Green 569nm LED Indication - Discrete 2.1V 0805 (2012 Metric) | https://www.digikey.ca/products/en?keywords=160-1179-1-ND
0215002.MXESPP | LittleFuse | Fuse | 10 | $0.87 | $8.73 | 2A 250V AC DC Fuse Cartridge, Ceramic Through Hole 5mm x 20mm (Axial) | https://www.digikey.ca/products/en?keywords=F3583-ND
CRCW080510K0FKEA | Vishay Dale | 10k Resistors | 100 | $0.04 | $3.89 | 10 kOhms ±1% 0.125W, 1/8W Chip Resistor 0805 (2012 Metric) Automotive AEC-Q200 Thick Film | https://www.digikey.ca/product-detail/en/vishay-dale/CRCW080510K0FKEA/541-10.0KCCT-ND/1180897
RC0805FR-07390RL | Yageo | 400ohm Resistors | 100 | $0.02 | $2.49 | 390 Ohms ±1% 0.125W, 1/8W Chip Resistor 0805 (2012 Metric) Moisture Resistant Thick Film | https://www.digikey.ca/products/en?keywords=311-390CRCT-ND
SLW-120-01-G-D | Samtec | TH Header | 2 | $8.65 | $17.30 | 40 Position Receptacle Connector Through Hole | https://www.digikey.ca/products/en?keywords=SAM1088-20-ND
DS18B20+T&R | Maxim Integrated | Temp Sensor | 2 | $5.74 | $11.48 | Temperature Sensor Digital, Local -55°C ~ 125°C 12 b TO-92-3 | https://www.digikey.ca/product-detail/en/maxim-integrated/DS18B20-T-R/DS18B20-T-RCT-ND/3478852
 |  | 0.1 uF Capacitor | 5 | $0.00 | $0.00
 |  |  |  | Total: | $131.36
 |  |  |  | Total: | $383.56 | CAD

Sheet: BOM
Qty | Part Number | Manufacturer | Ref. Designator | Package | Description
1 | TBD | TBD | C1 | TH-2.54MM | Capacitor 0.1uF TH
1 | TBD | TBD | C2 | TH-5.08MM | Capacitor 100uF TH
1 | LM4040CIZ-2.5 | Texas Instruments | D1 | TO-92 | Voltage Reference - Zener Diode
1 | TBD | TBD | D2 | TH-2.54MM | LED Red TH
1 | LTST-C170GKT | Lite-On Inc. | D3 | 0805 | LED Green 0805
1 | APT2012SURCK | Kingbright | D4 | 0805 | LED Red 0805
1 | LTST-C171KSKT | Lite-On Inc. | D5 | 0805 | LED Yellow 0805
1 | SOLDERING_PADS | SOLDERING_PADS | E1 | SOLDERING_PADS | Pads for soldering wires
1 | 0215002.MXESPP | LittleFuse | F1 | TH 5mm x 20mm (Axial) | 2A Fuse
1 | HDR1X2-P2.54MM | TBD | J1 | HDR1X2 | Header 2pin 2.54mm pitch
1 | HDR2X7-P2.54MM | TBD | J2 | HDR2X7 | Header 14pin 2.54mm pitch
1 | FQP27P06 | ON Semiconductor | Q1 | TO-220-BEND | P-MOSFET
5 | CRCW080510K0FKEA | Vishay Dale | R1, R4, R5, R11, R12 | 0805 | 10kohm 0805 1/8W
1 | PV36W104C01B00 | Bourns Inc. | R2 | TH | 100k Potentiometer
7 | RC0805FR-07390RL | Yageo | R3, R6, R7, R8, R9, R10, R13 | 0805 | 400ohm 0805 1/8W
2 | PMS9P1B10M2QE | TE Connectivity | SW1, SW2 | TH | Switch SPST
1 | LM393AP | Texas Instruments | U1 | DIP8 | Comparator
2 | TSR 2-2450 | Traco Power | U2, U3 | TH | DC/DC Converter
1 | DS18B20+T&R | Maxim Integrated | U4 | TO-92 | Digital Temp. Sensor
1 | SLW-120-01-G-D | Samtec | U5 | PI_3A+ | 40 Position Receptacle Connector Through Hole
