ArthurBondar/Tow-Camera-Public/PCB/Rev. A/BOM.xlsx

Qty | Part Number | Ref. Designator | Value | Package | Description
1 | CAPACITORRAD-3MM | C1 | 0.1uF | CAPPRD254W65D300H300B | Capacitor
1 | FUSE0215002.MXESPP | F1 | 0215002.MXESPP | 0215002.MXESPP | Fuse - Various Devices
1 | PV36W104C01B00 | R2 | 100k | PV36W104C01B00 | PV36W104C01B00 Bourns Inc.
1 | CAP_THCAP-TH-5MM | C2 | 100uF | CAP-TH-5MM | Capacitor Electro. TH
5 | RESISTOR0805 | R1, R4, R5, R11, R12 | 10k | R0805 | Resistor US
7 | RESISTOR0805 | R3, R6, R7, R8, R9, R10, R13 | 400 | R0805 | Resistor US
1 | DS18B20 | U4 | DS18B20 | TO-92 | DS18B20+T&R Maxim Integrated
1 | LED0805 | D5 | ERR | R0805 | LED GENERIC
1 | HDR1X22P2.54MM | J1 | FET_BYPASS | HDR1X2 | Header 2pin 2.54mm pitch
1 | FQP27P06 | Q1 | FQP27P06 | TO-220-BEND | FQP27P06 ON Semiconductor
1 | HDR2X7HDR2X7 | J2 | HDR2X7HDR2X7 | HDR2X7
1 | LM393APDIP8 | U1 | LM393AP | DIP8 | LM393AP Texas Instruments
1 | ZENERLM4040CIZ-2.5 | D1 | LM4040CIZ-2.5 | TO-92 | Voltage Reference - Zener Diode
2 | SPSTPMS9P1B10M2QE | SW1, SW2 | PMS9P1B10M2QE | PMS9P1B10M2QE | Switch SPST
1 | LED0805 | D3 | PWR | R0805 | LED GENERIC
1 | LED0805 | D4 | REC | R0805 | LED GENERIC
1 | LED_THLED-2.54 | D2 | REC2 | LEDRD254W60D565H860B | TH LED - large
1 | RPIPI_3A+ | U5 | RPIPI_3A+ | PI_3A+ | Pi Header with different package variations
1 | SOLDERING_PADS | E1 | SOLDERING_PADS | SOLDERING_PADS | Pads for soldering wires
2 | TSR2-2450 | U2, U3 | TSR2-2450 | TSR2-2450 | TSR 2-2450 Traco Power
