ArthurBondar/Tow-Camera-Public/Model/Assemblies/Tow Camera v1 STEP/3D printing parts list.xlsx

Tow Camera v1
December 21, 2019
# | Part Name | Qty | Layer Height | Shell Thickness | Infill
1 | BackAttachment | 1 | 0.2 mm | x3 | 30%
2 | BattSpacer | 12 | 0.2 mm | x2 | 30%
3 | BattSupportCircle | 3 | 0.2 mm | x2 | 20%
4 | MidAttachment | 1 | 0.2 mm | x2 | 20%
5 | Platform | 1 | 0.2 mm | x2 | 20%
6 | PiStandoff | 4 | 0.2 mm | x3 | 30%
7 | FrontAttachment | 1 | 0.2 mm | x3 | 30%
