ArthurBondar/Tow-Camera-Public/PCB/Rev. A/Item List.xlsx

Line Camera and Underwater Camera Rev. A Purchase List
2019-11-26
Part Number | Manufactureer | Device | Qty. | Price (CAD) | Extended | Description | Link
Main Components
913-2664 | RPI Foundation | Pi Camera V2 | 1 | $42.53 | $42.53 | IMX219 Camera Sensor Raspberry Pi Platform Evaluation Expansion Board | https://www.digikey.ca/product-detail/en/raspberry-pi/913-2664/1690-1011-ND/6152810
DEV-14277 | RPI Foundation | Raspberry Pi 3 Model A+ | 1 | $42.67 | $42.67 | BCM2837B0 Raspberry Pi 3 Model A+ - ARM® Cortex®-A53, VideoCore | https://www.digikey.ca/product-detail/en/raspberry-pi/RASPBERRY-PI-3-A/1690-1028-ND/9760878
JST-HX | JST | Charging connector | 1 | $1.70 | $1.70 | Lead Extension (20cm JST-XH) | https://www.ebay.ca/itm/Lipo-Battery-2S-3S-4S-6S-Balance-Lead-Extension-Plug-Charger-Cable-20cm-JST-XH/193034671421
IMAX B6 Mini | SkyRC | Balance Charger1-6S 6A/60W | 1 | $34.88 | $34.88 | SKYRC IMAX B6 Mini Balance Charger/Discharger For RC Lipo Battery Charging S1M4 | https://www.ebay.ca/itm/SKYRC-IMAX-B6-Mini-Balance-Charger-Discharger-For-RC-Lipo-Battery-Charging-S1M4/392447287037
16GB Class 10 MicroSD | SanDisk | MicroSD module | 1 | $9.35 | $9.35 | Regular microSD module | https://www.ebay.ca/itm/SanDisk-Micro-SD-Class10-TF-Memory-Card-4GB-8GB-16GB-32GB-64GB-128GB-SDHC/362581673097
 |  | Timing control PCB | 1 | $5.00 | $5.00 | Main Stacking board for arduino timing controller
 |  | Battery Protection PCB | 1 | $5.00 | $5.00 | Battery undervoltage protection board with fuses and connectors
ICs
ATMEGA328P-PU | Microchip | Microcontroller | 1 | $3.15 | $3.15 | AVR AVR® ATmega Microcontroller IC 8-Bit 20MHz 32KB (16K x 16) FLASH 28-PDIP | https://www.digikey.ca/products/en?keywords=ATMEGA328P-PU-ND
TSR 2-2450 | Traco Power | DC/DC Converter | 1 | $17.78 | $17.78 | Linear Regulator Replacement DC DC Converter 1 Output 5V 2A 6.5V - 36V Input | https://www.digikey.ca/product-detail/en/traco-power/TSR-2-2450/1951-2692-ND/9383726
MAX6035BAUR50+T | Texas Inst. | Voltage Reference IC | 1 | $2.83 | $2.83 | Series Voltage Reference IC ±0.5% SOT-23-3 | https://www.digikey.ca/products/en?keywords=MAX6035BAUR50%2BTCT-ND
LT6700CS6-3#TRMPBF | Linear Tech | Comparator | 1 | $4.82 | $4.82 | Comparator with Voltage Reference Open Collector TSOT-23-6 | https://www.digikey.ca/products/en?keywords=LT6700CS6-3%23TRMPBFCT-ND
AOI21357 | Alpha & Omega | P-Ch. MOSFET | 2 | $0.88 | $1.76 | P-Channel 30V 23A (Ta), 70A (Tc) 6.2W (Ta), 78W (Tc) Through Hole TO-251A | https://www.digikey.ca/products/en?keywords=785-1836-ND
 |  |  |  | $0.06 | $0.00
 |  |  |  | $0.14 | $0.00
 |  |  |  | $0.14 | $0.00
 |  |  |  | $0.15 | $0.00
 |  |  |  | $0.38 | $0.00
 |  |  |  | $1.71 | $0.00
Passives
746 |  | Ultimate GPS |  | $51.94 | $0.00 | GPS Module | https://www.adafruit.com/product/746
3012 |  | Real Time Clock |  | $18.13 | $0.00 | RTC - DS3231 Clock | https://www.adafruit.com/product/3013
1294 |  | micro SD card 8GB |  | $12.93 | $0.00 | MicroSD card for Pi software | https://www.adafruit.com/product/1294
2243 |  | 40-pin Female Header |  | $2.54 | $0.00 | Pi Header for Line Camera | https://www.adafruit.com/product/2243
4064 |  | Metro M4 MCU |  | $48.75 | $0.00 | Microcontroller for testing | https://www.adafruit.com/product/4064
3196 |  | LiPo SHIM |  | $12.93 | $0.00 | Boost converter | https://www.adafruit.com/product/3196
Mechanical
SanDisk 256GB |  | micro SD card 256GB |  | $60.00 | $0.00 | MicroSD for video storage | https://www.amazon.ca/SanDisk-SDSQUAR-256G-GN6MA-Ultra-256GB-microSDXC-Adapter/dp/B0758NHWS8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
DS3231SN |  | Real Time Clock |  | $3.69 | $0.00 | Time keeping circuit | https://www.amazon.ca/DS3231-Arduino-EEPROM-Battery-Universal-Solder/dp/B07BCPRH6F?s=gateway
 |  |  |  | Total: | $171.47 | CAD
