ArthurBondar/Tow-Camera-Public/Documentation/Datasheets/ATS-CPX-113-CX-R0_FUSED.STEP

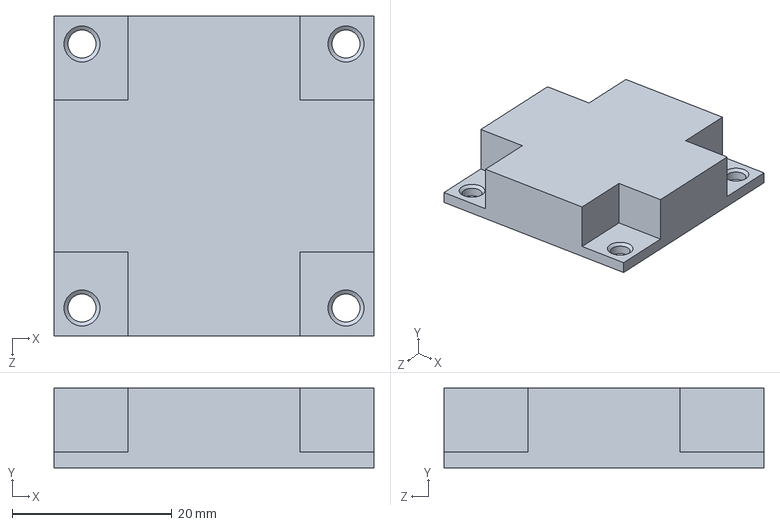
[picture p28: CAD file, 2024-05-27]
Documentation/Datasheets/ATS-CPX-113-CX-R0_FUSED.STEP
40.0 x 10.0 x 40.0 mm
