ArthurBondar/Tow-Camera-Public/Model/Assemblies/stand_section.stl

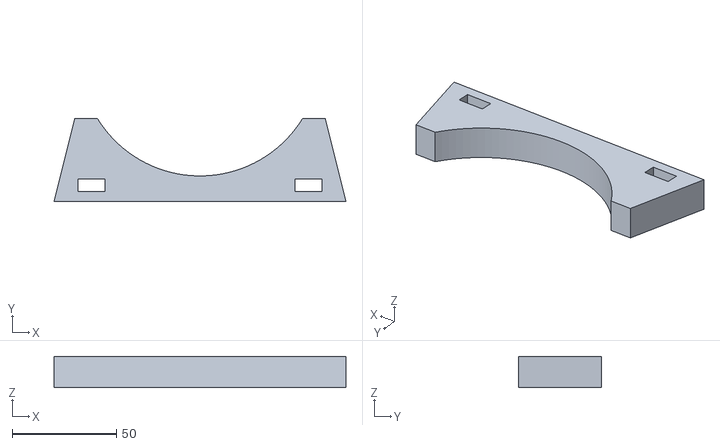
[picture p29: CAD file, 2024-05-27]
Model/Assemblies/stand_section.stl
140.0 x 40.0 x 15.0
