ArthurBondar/Tow-Camera-Public/Model/Assemblies/Tow Camera v1 STEP/4-MidAttachment.step

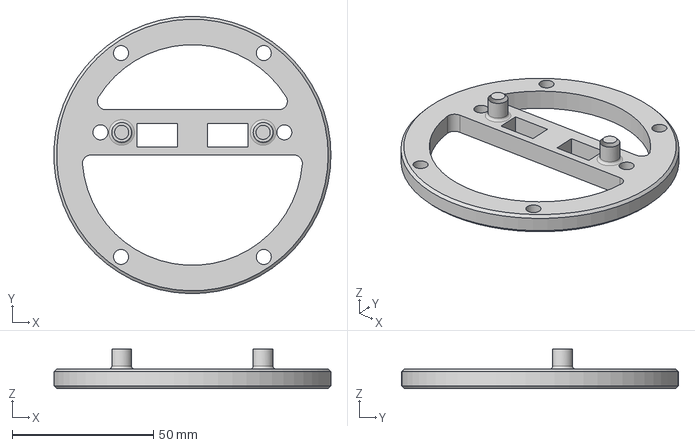
[picture p30: CAD file, 2024-05-27]
Model/Assemblies/Tow Camera v1 STEP/4-MidAttachment.step
97.9 x 98.0 x 15.0 mm
