ArthurBondar/Tow-Camera-Public/Model/Assemblies/Tow Camera v1.2/3d printed parts/PiStandoff.stl

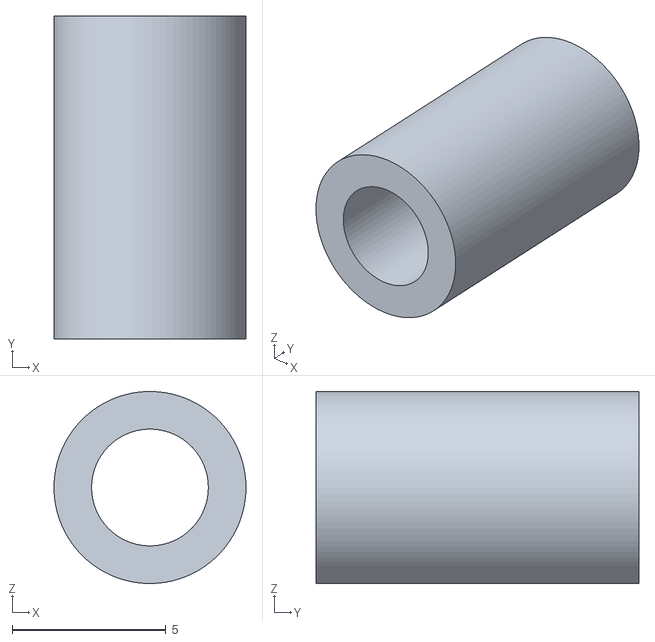
[picture p31: CAD file, 2024-05-27]
Model/Assemblies/Tow Camera v1.2/3d printed parts/PiStandoff.stl
6.25 x 10.5 x 6.25
