ArthurBondar/Tow-Camera-Public/Model/Assemblies/Tow Camera v1.2/Clamp.step

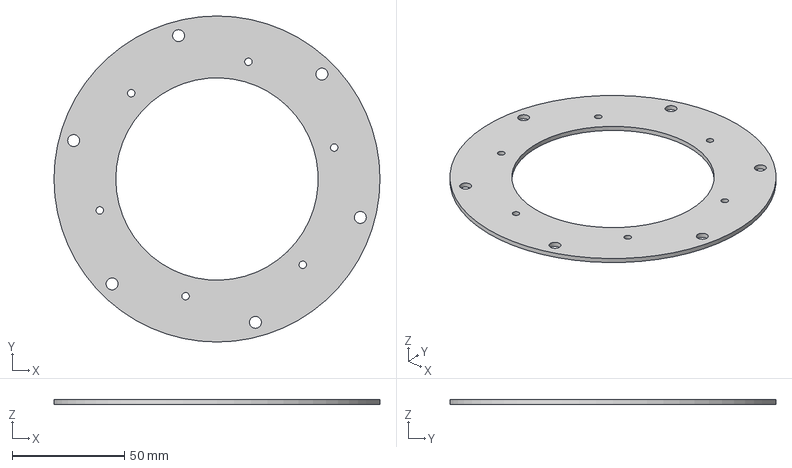
[picture p32: CAD file, 2024-05-27]
Model/Assemblies/Tow Camera v1.2/Clamp.step
145.0 x 145.0 x 2.06 mm
