ArthurBondar/Tow-Camera-Public/Model/Assemblies/Tow Camera v1.2/Frame_DXF/Platform.dxf

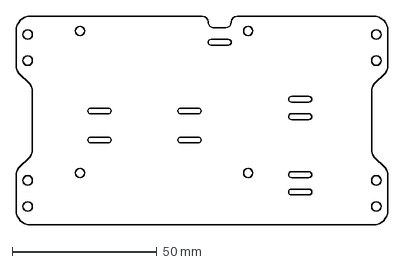
[picture p33: CAD file, 2024-05-27]
Model/Assemblies/Tow Camera v1.2/Frame_DXF/Platform.dxf
128.3 x 72.0 mm
