ArthurBondar/Tow-Camera-Public/Model/Misc/CameraHolder/STL/HolderBottom.stl

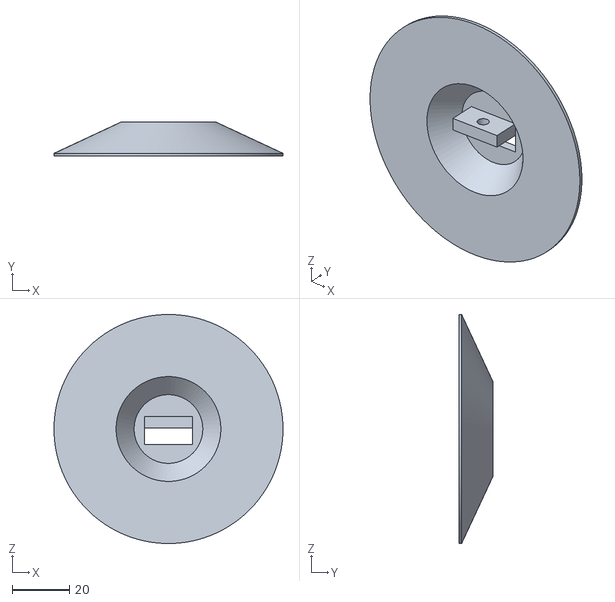
[picture p35: CAD file, 2024-05-27]
Model/Misc/CameraHolder/STL/HolderBottom.stl
80.0 x 12.0 x 80.0
