ArthurBondar/Tow-Camera-Public/PCB/Rev. A/3D Models/11-PIHER_3D_PT10MH01.STEP

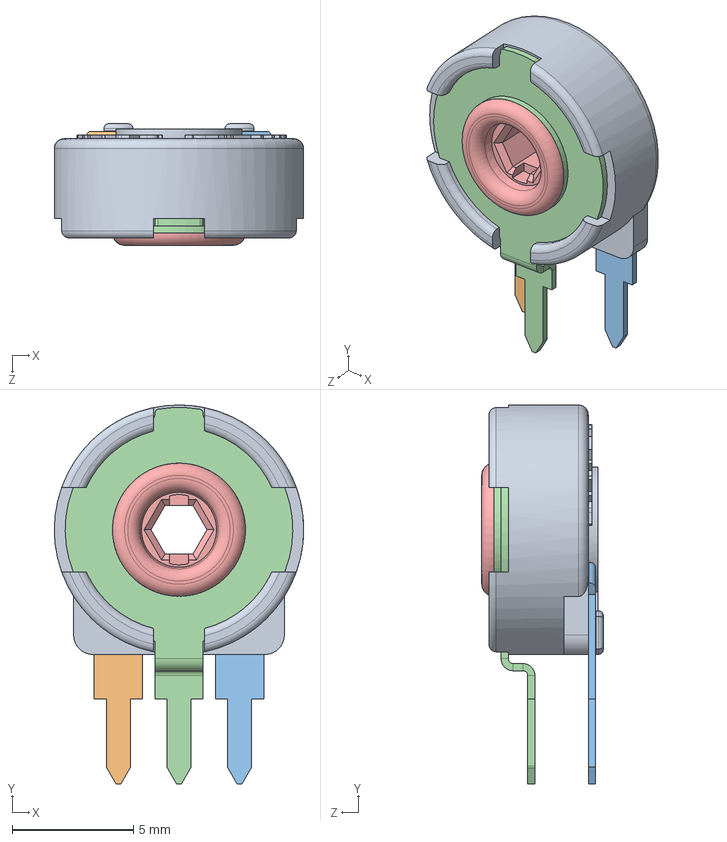
[picture p36: CAD file, 2024-05-27]
PCB/Rev. A/3D Models/11-PIHER_3D_PT10MH01.STEP
10.3 x 15.7 x 5.02 mm
PT10MH01-CARCASA
PT10MH01-TERMINAL DERECHO
PT10MH01-TERMINAL IZQUIERDO
PT10MH01-COLECTOR
PT10MH01-PORTACURSOR_Predeterminada
