ArthurBondar/Tow-Camera-Public/Model/Assemblies/Tow Camera v1 STEP/2-BattSpacer.step

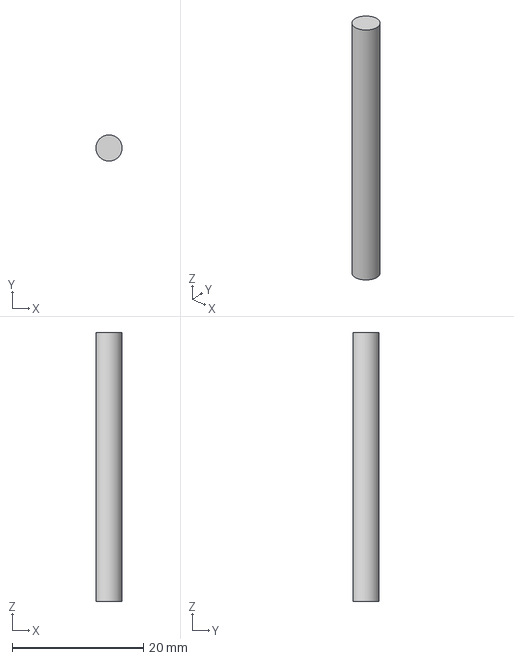
[picture p37: CAD file, 2024-05-27]
Model/Assemblies/Tow Camera v1 STEP/2-BattSpacer.step
4.00 x 4.00 x 41.0 mm
