ArthurBondar/Tow-Camera-Public/Model/Assemblies/Tow Camera v1 STL ASCII/1-BackAttachment ASCII.stl

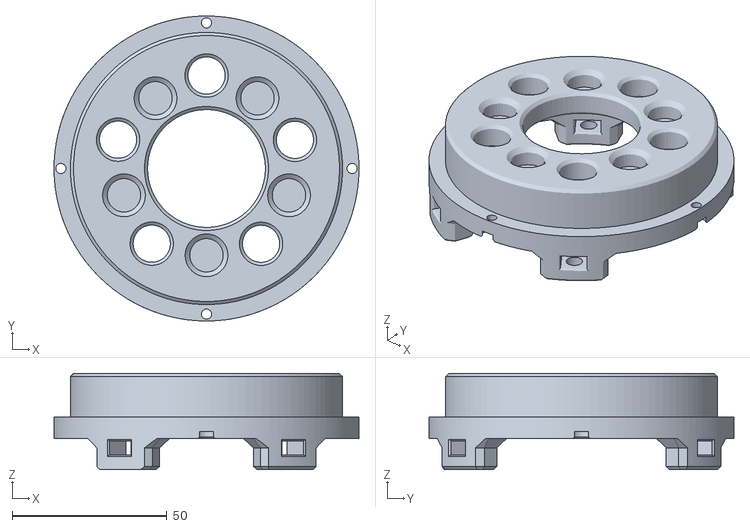
[picture p38: CAD file, 2024-05-27]
Model/Assemblies/Tow Camera v1 STL ASCII/1-BackAttachment ASCII.stl
98.4 x 98.4 x 31.0
