ArthurBondar/Tow-Camera-Public/Model/Assemblies/Tow Camera v1.2/3d printed parts/Flange spacer.stl

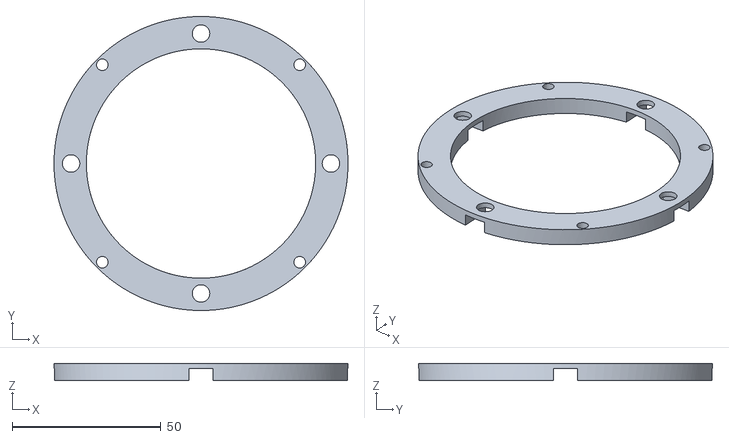
[picture p39: CAD file, 2024-05-27]
Model/Assemblies/Tow Camera v1.2/3d printed parts/Flange spacer.stl
99.0 x 99.0 x 5.80
