ArthurBondar/Tow-Camera-Public/Model/Assemblies/Tow Camera v1.2/BackFlange.step

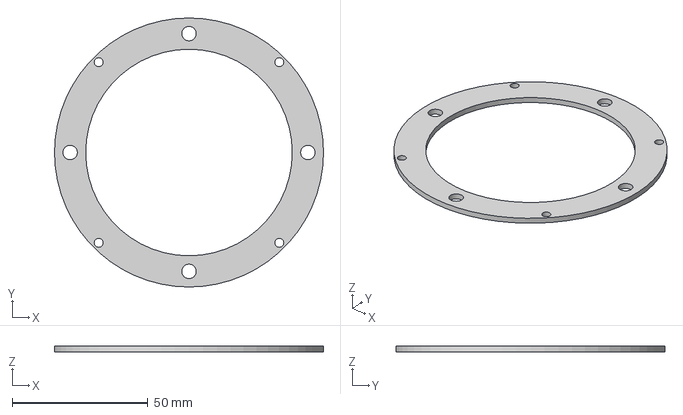
[picture p40: CAD file, 2024-05-27]
Model/Assemblies/Tow Camera v1.2/BackFlange.step
99.0 x 99.0 x 2.06 mm
