ArthurBondar/Tow-Camera-Public/Model/Assemblies/Tow Camera v1.2/Frame_DXF/Clamp.dxf

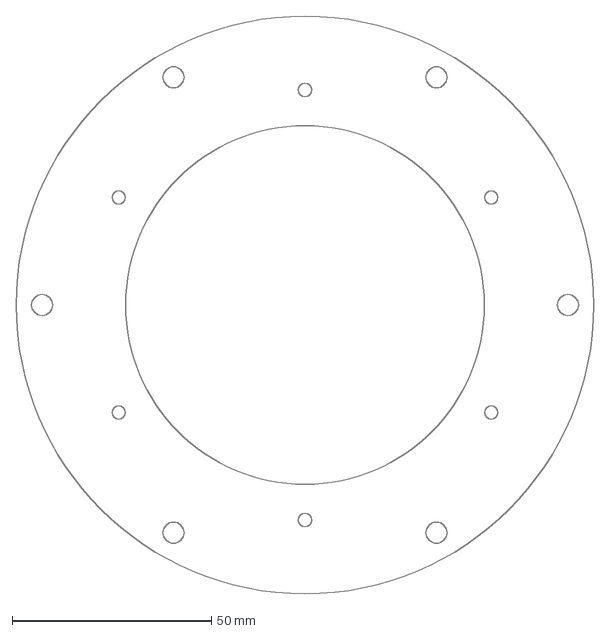
[picture p41: CAD file, 2024-05-27]
Model/Assemblies/Tow Camera v1.2/Frame_DXF/Clamp.dxf
145.0 x 145.0 mm
