ArthurBondar/Tow-Camera-Public/Model/Assemblies/Tow Camera v1.2/Protocase Order/Order 1 confimarmation files/Platfrom.step

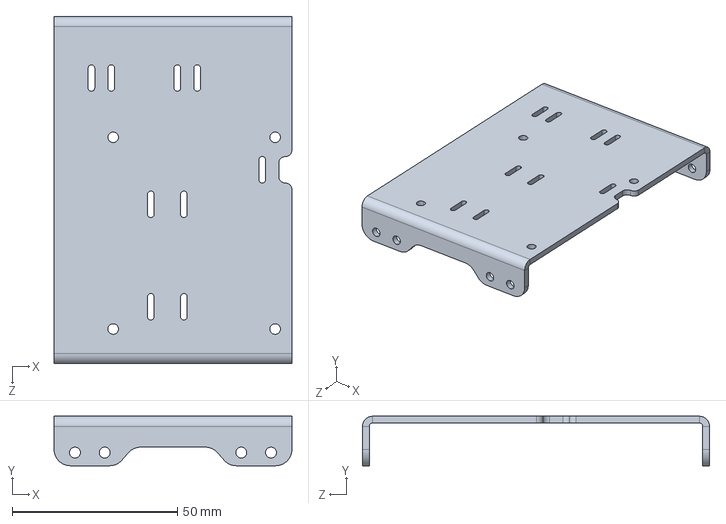
[picture p42: CAD file, 2024-05-27]
Model/Assemblies/Tow Camera v1.2/Protocase Order/Order 1 confimarmation files/Platfrom.step
72.0 x 15.0 x 105.0 mm
