ArthurBondar/Tow-Camera-Public/Model/Misc/CameraHolder/STL/HolderTop.stl

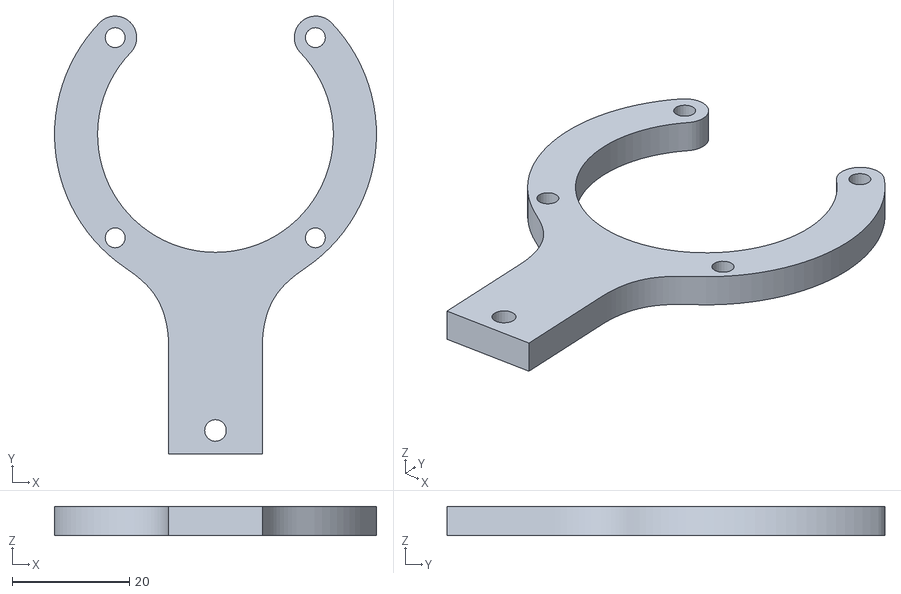
[picture p43: CAD file, 2024-05-27]
Model/Misc/CameraHolder/STL/HolderTop.stl
55.0 x 74.8 x 5.00
