ArthurBondar/Tow-Camera-Public/PCB/Rev. A/3D Models/PV36W104C01B00.stp

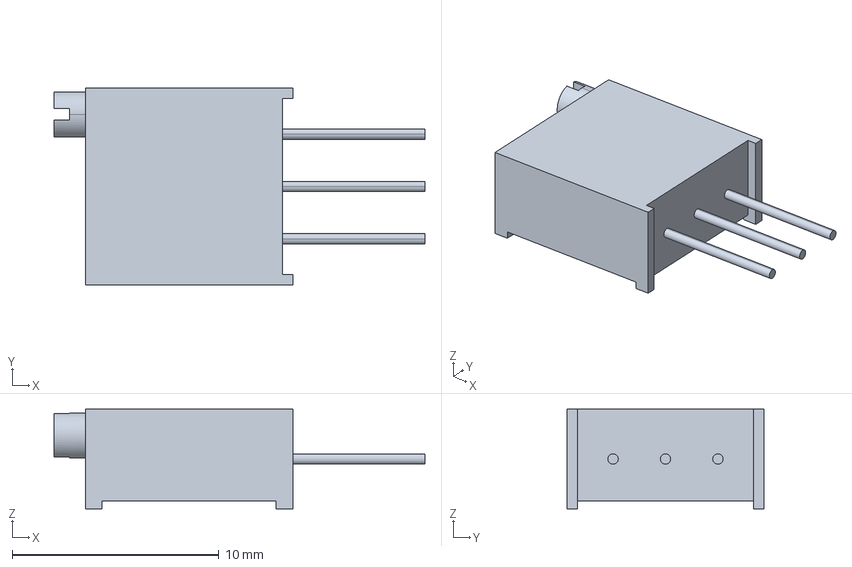
[picture p44: CAD file, 2024-05-27]
PCB/Rev. A/3D Models/PV36W104C01B00.stp
18.0 x 9.52 x 4.83 mm
