ArthurBondar/Tow-Camera-Public/Model/Assemblies/Tow Camera v1 STEP/7-FrontAttachment.step

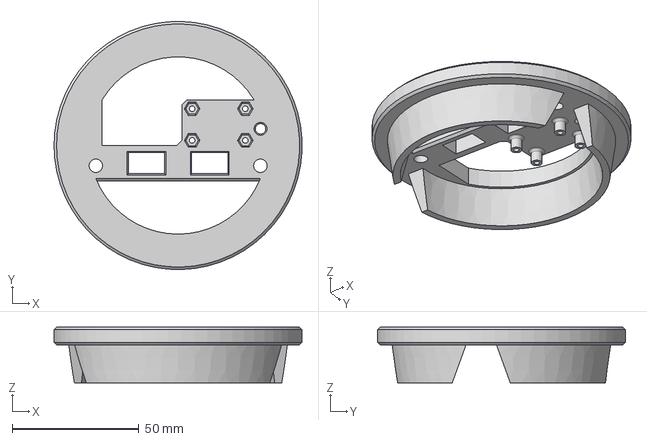
[picture p45: CAD file, 2024-05-27]
Model/Assemblies/Tow Camera v1 STEP/7-FrontAttachment.step
97.9 x 98.0 x 22.0 mm
