ArthurBondar/Tow-Camera-Public/Model/Assemblies/Tow Camera v1 STL ASCII/3-BattSupportCircle ASCII.stl

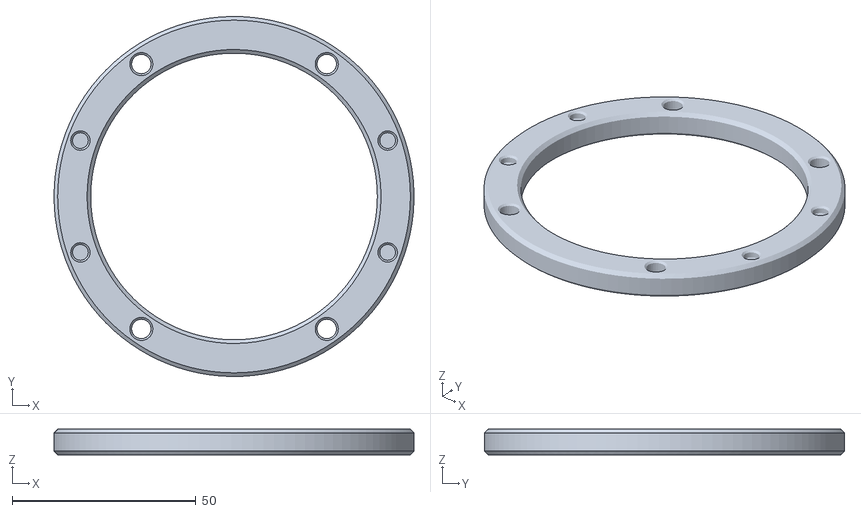
[picture p46: CAD file, 2024-05-27]
Model/Assemblies/Tow Camera v1 STL ASCII/3-BattSupportCircle ASCII.stl
98.0 x 98.0 x 7.00
