ArthurBondar/Tow-Camera-Public/Model/Assemblies/Tow Camera v1.2/3d printed parts/Camera bracket.stl

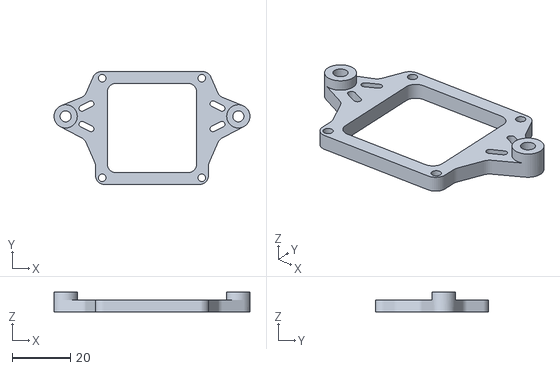
[picture p47: CAD file, 2024-05-27]
Model/Assemblies/Tow Camera v1.2/3d printed parts/Camera bracket.stl
67.3 x 38.8 x 6.70
