ArthurBondar/Tow-Camera-Public/Model/Assemblies/Tow Camera v1.2/Bracket.step

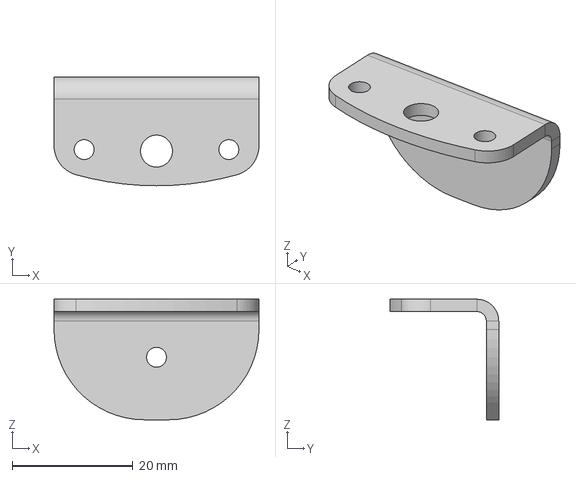
[picture p48: CAD file, 2024-05-27]
Model/Assemblies/Tow Camera v1.2/Bracket.step
34.0 x 18.0 x 20.0 mm
