ArthurBondar/Tow-Camera-Public/PCB/Rev. A/3D Models/SLW-120-01-G-D.stp

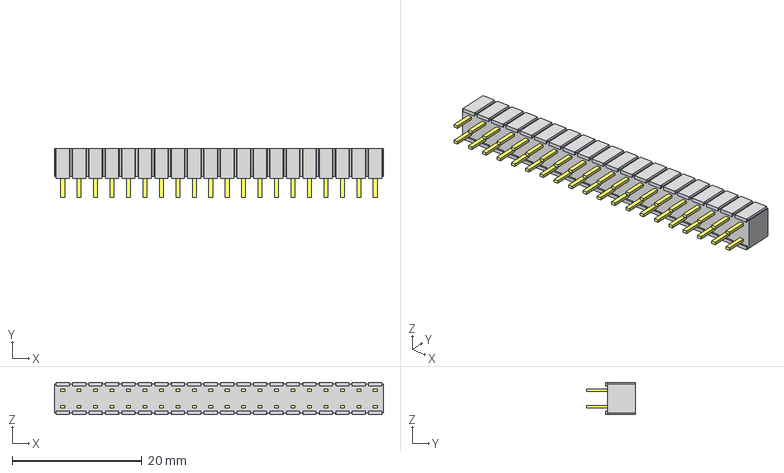
[picture p49: CAD file, 2024-05-27]
PCB/Rev. A/3D Models/SLW-120-01-G-D.stp
50.8 x 7.49 x 4.95 mm
_SLW-120-01-D_socket
_C-28-01-20-D
