ArthurBondar/Tow-Camera-Public/Model/Assemblies/Tow Camera v1.2/3d printed parts/BatteryHolder.stl

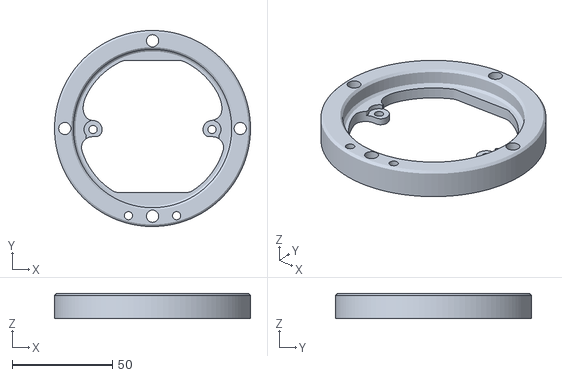
[picture p50: CAD file, 2024-05-27]
Model/Assemblies/Tow Camera v1.2/3d printed parts/BatteryHolder.stl
97.8 x 97.8 x 12.5
