ArthurBondar/Tow-Camera-Public/PCB/Rev. A/3D Models/TSR 2-2450.step

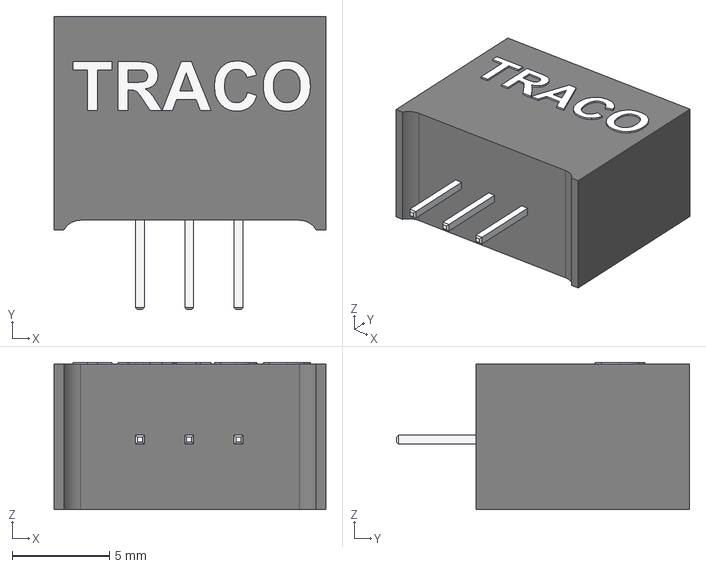
[picture p53: CAD file, 2024-05-27]
PCB/Rev. A/3D Models/TSR 2-2450.step
14.0 x 15.1 x 7.60 mm
