ArthurBondar/Tow-Camera-Public/Model/Assemblies/Tow Camera v1.2/3d printed parts/PiStandoffPCB.stl

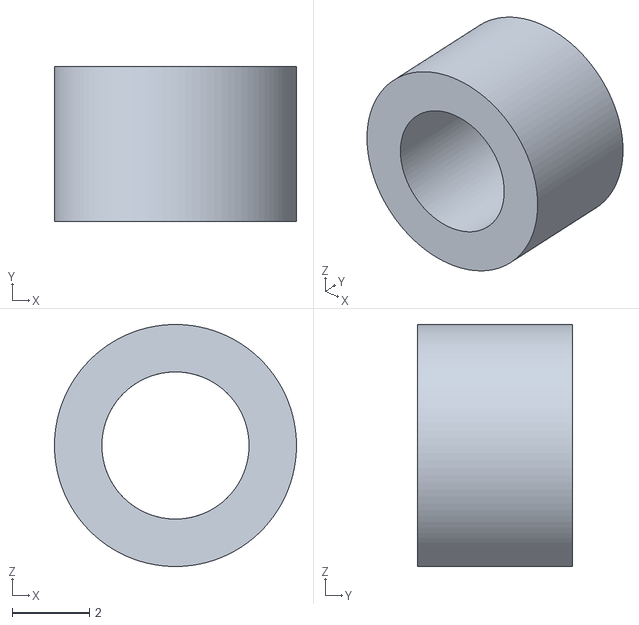
[picture p54: CAD file, 2024-05-27]
Model/Assemblies/Tow Camera v1.2/3d printed parts/PiStandoffPCB.stl
6.25 x 4.00 x 6.25
