ArthurBondar/Tow-Camera-Public/Model/Assemblies/Tow Camera v1.2/Frame_DXF/FrontFlange.dxf

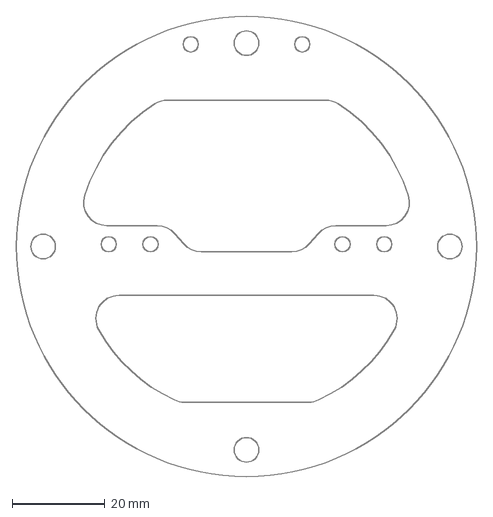
[picture p55: CAD file, 2024-05-27]
Model/Assemblies/Tow Camera v1.2/Frame_DXF/FrontFlange.dxf
99.0 x 99.0 mm
