ArthurBondar/Tow-Camera-Public/PCB/Rev. A/3D Models/12-PIHER_3D_PT10LH02.STEP

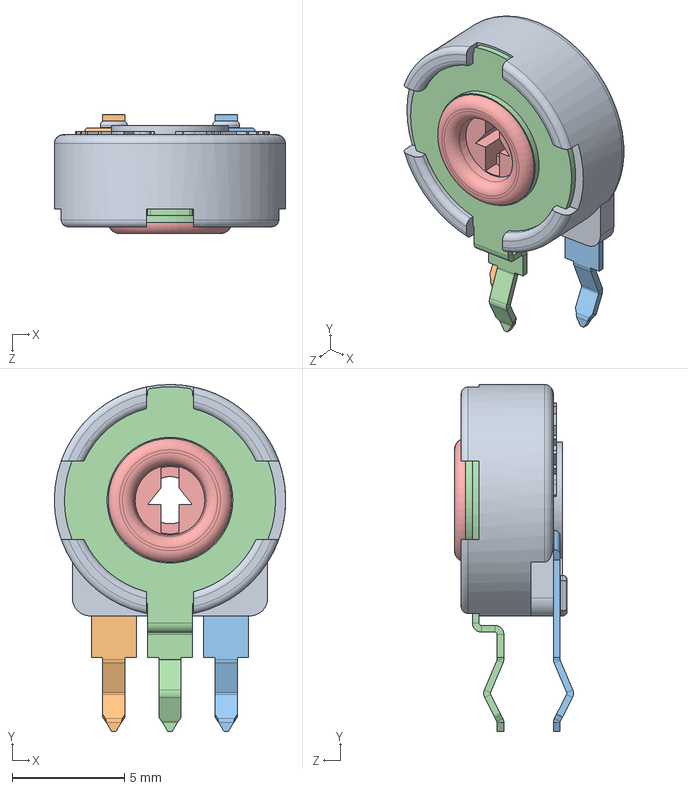
[picture p56: CAD file, 2024-05-27]
PCB/Rev. A/3D Models/12-PIHER_3D_PT10LH02.STEP
10.3 x 15.4 x 5.30 mm
PT10LH02-CARCASA
PT10LH02-TERMINAL DERECHO
PT10LH02-TERMINAL IZQUIERDO
PT10LH02-COLECTOR
PT10LH02-PORTACURSOR_Predeterminada
