ArthurBondar/Tow-Camera-Public/Model/Assemblies/Tow Camera v1 STEP/6-PiStandoff.step

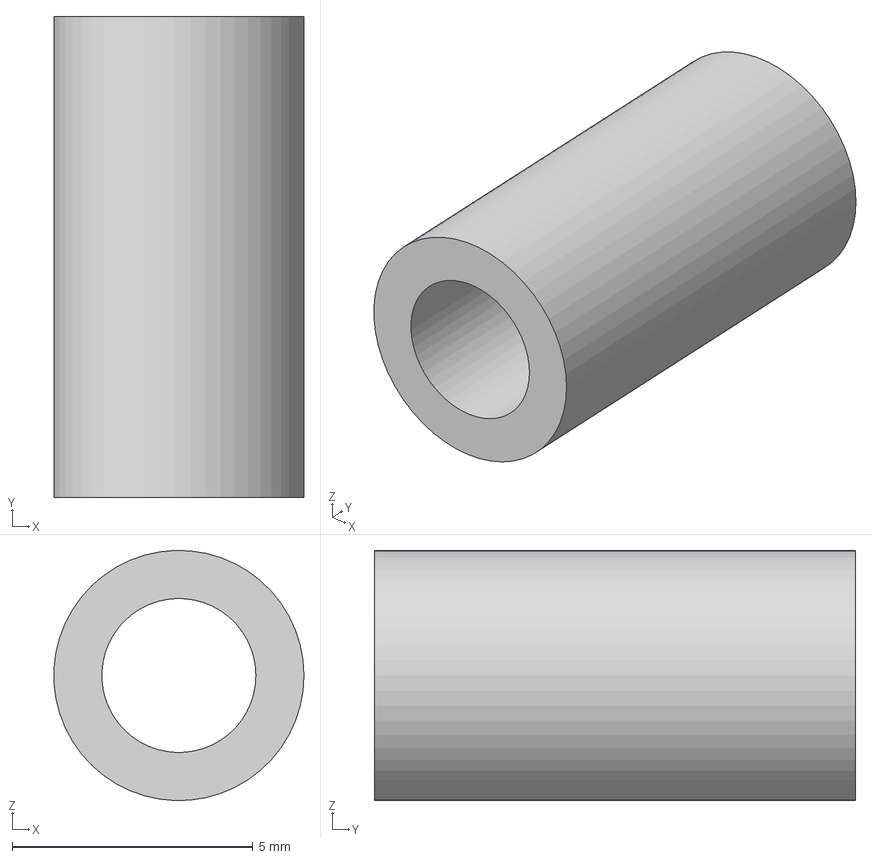
[picture p57: CAD file, 2024-05-27]
Model/Assemblies/Tow Camera v1 STEP/6-PiStandoff.step
5.20 x 10.0 x 5.20 mm
