ArthurBondar/Tow-Camera-Public/PCB/Rev. A/3D Models/TO-92.stp

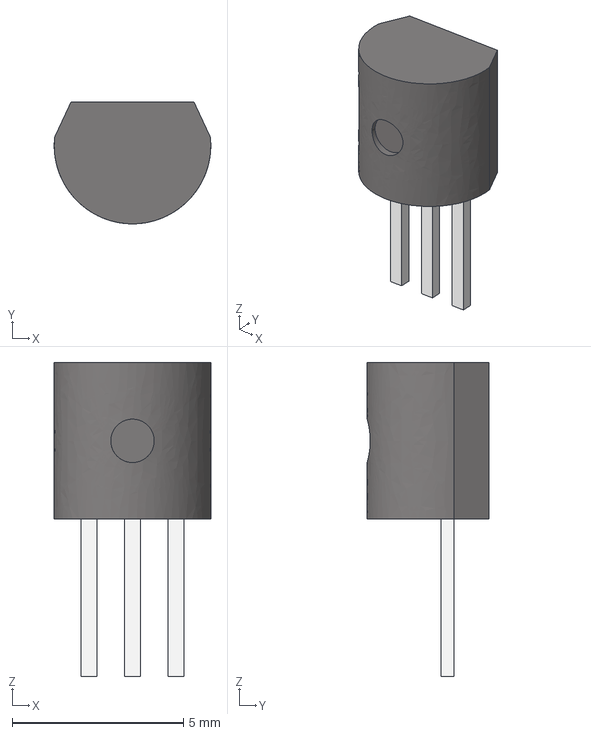
[picture p58: CAD file, 2024-05-27]
PCB/Rev. A/3D Models/TO-92.stp
4.58 x 3.56 x 9.18 mm
