ArthurBondar/Tow-Camera-Public/Model/Assemblies/Tow Camera v1 STEP/5-Platform.step

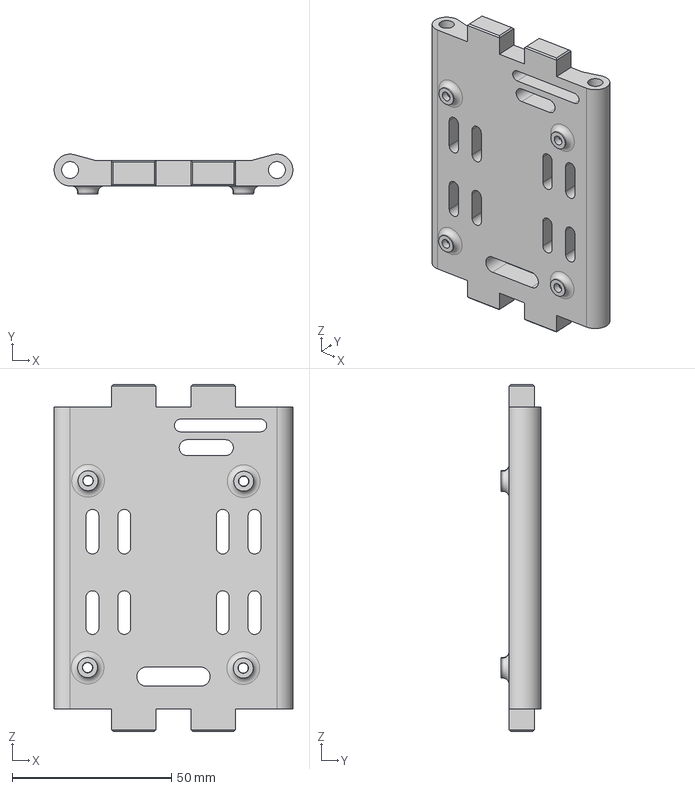
[picture p59: CAD file, 2024-05-27]
Model/Assemblies/Tow Camera v1 STEP/5-Platform.step
75.0 x 12.5 x 109.0 mm
