ArthurBondar/Tow-Camera-Public/Model/Assemblies/Tow Camera v1 STL ASCII/5-Platform ASCII.stl

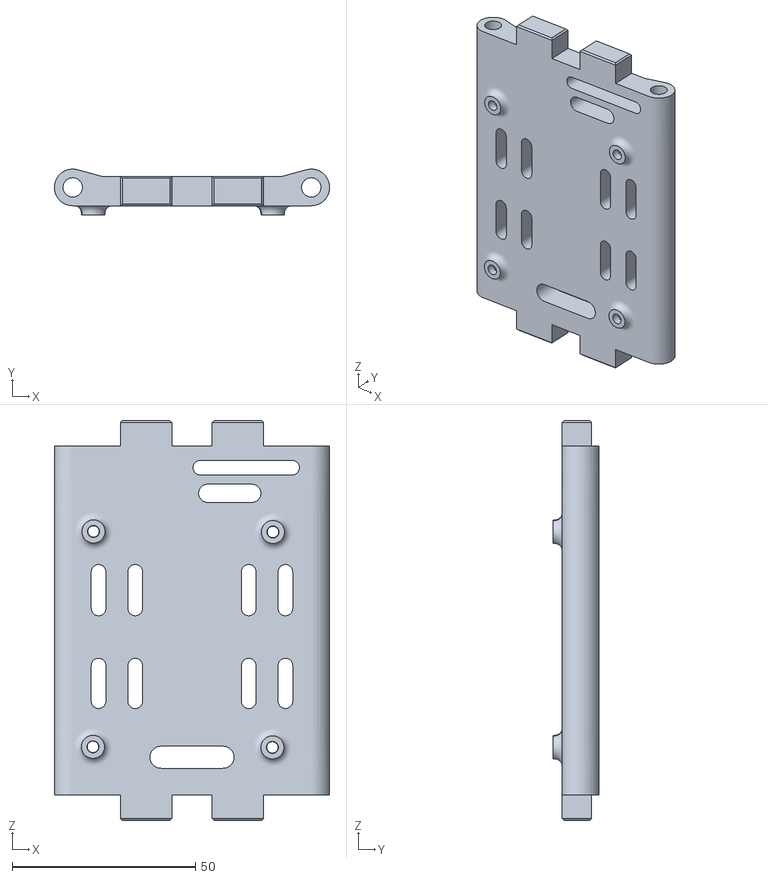
[picture p60: CAD file, 2024-05-27]
Model/Assemblies/Tow Camera v1 STL ASCII/5-Platform ASCII.stl
75.0 x 12.5 x 109.0
