ArthurBondar/Tow-Camera-Public/PCB/Rev. A/3D Models/AS11AP.stp

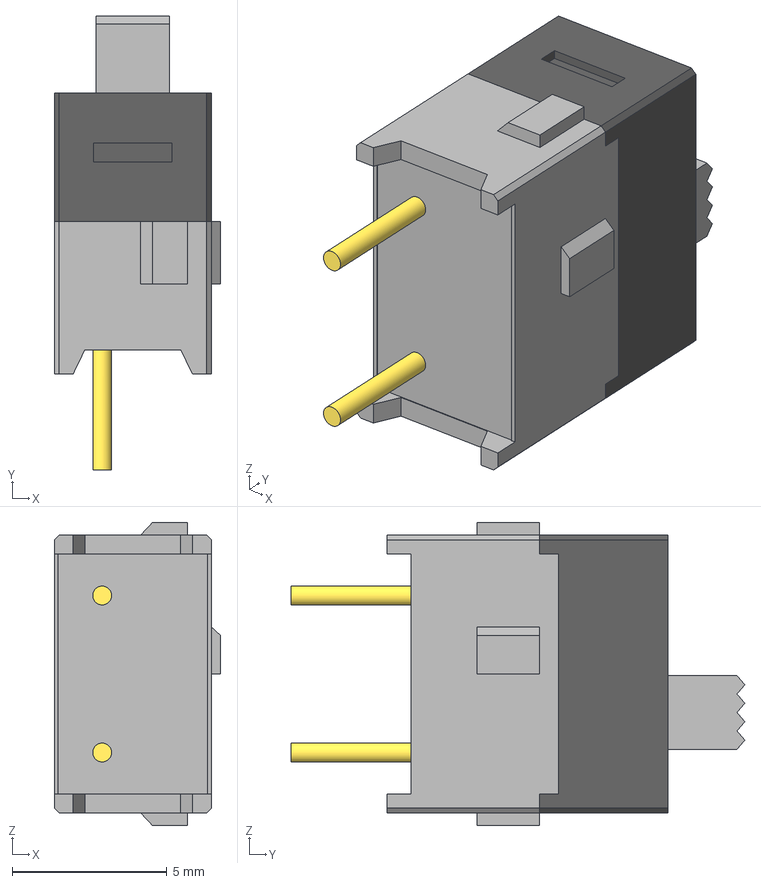
[picture p61: CAD file, 2024-05-27]
PCB/Rev. A/3D Models/AS11AP.stp
5.38 x 14.7 x 9.80 mm
_AS11APbody12
_AS11APbody1
_AS11APalong
_AS11APp
