ArthurBondar/Tow-Camera-Public/Model/Assemblies/Tow Camera v1.2/Frame_DXF_original/Bracket.dxf

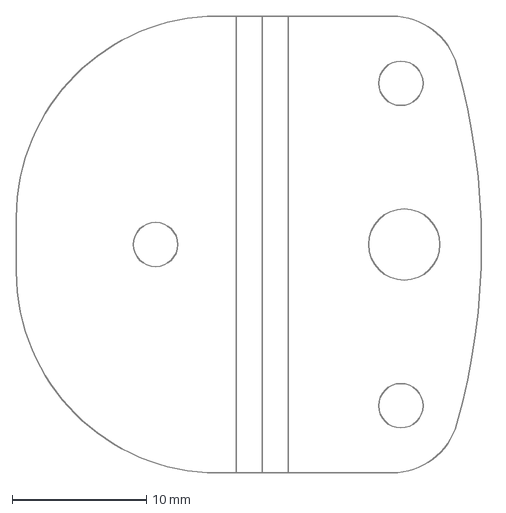
[picture p62: CAD file, 2024-05-27]
Model/Assemblies/Tow Camera v1.2/Frame_DXF_original/Bracket.dxf
35.2 x 34.0 mm
