ArthurBondar/Tow-Camera-Public/PCB/Rev. A/3D Models/PMS9P1B10M2QE.stp

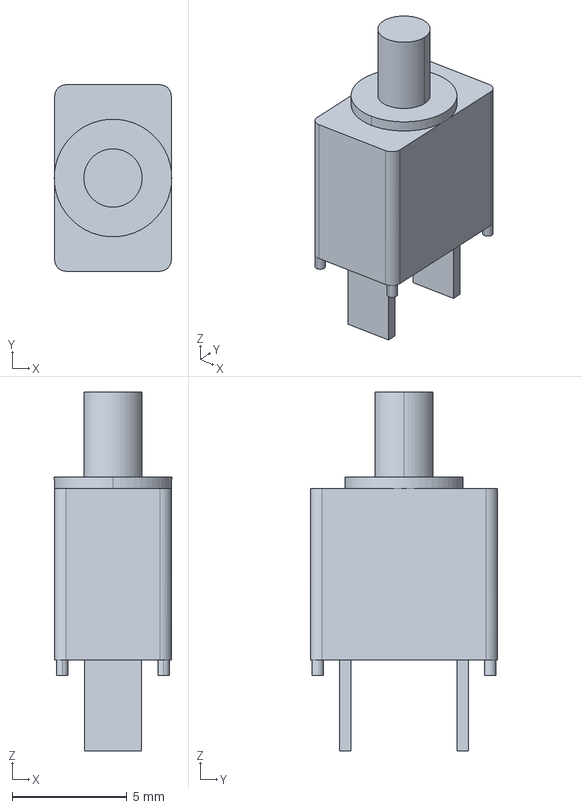
[picture p63: CAD file, 2024-05-27]
PCB/Rev. A/3D Models/PMS9P1B10M2QE.stp
5.12 x 8.13 x 15.6 mm
