ArthurBondar/Tow-Camera-Public/PCB/Rev. A/3D Models/TO-92 Formed Leads.stp

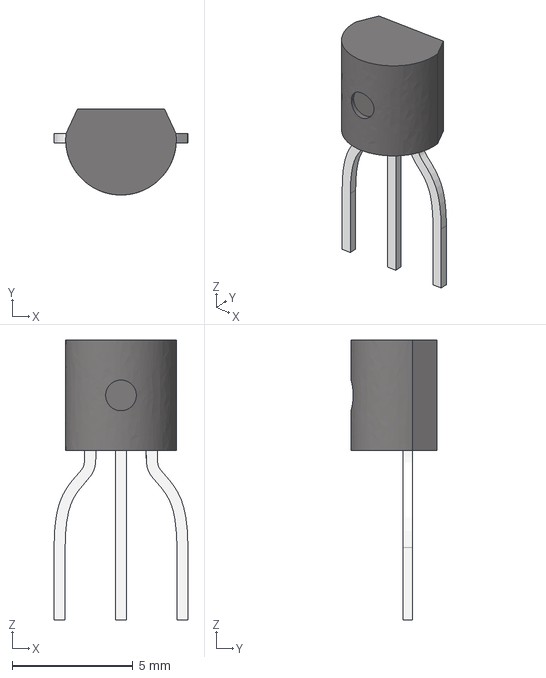
[picture p64: CAD file, 2024-05-27]
PCB/Rev. A/3D Models/TO-92 Formed Leads.stp
5.54 x 3.56 x 11.6 mm
