ArthurBondar/Tow-Camera-Public/PCB/Rev. A/3D Models/9-PIHER_3D_PT10MV10.STEP

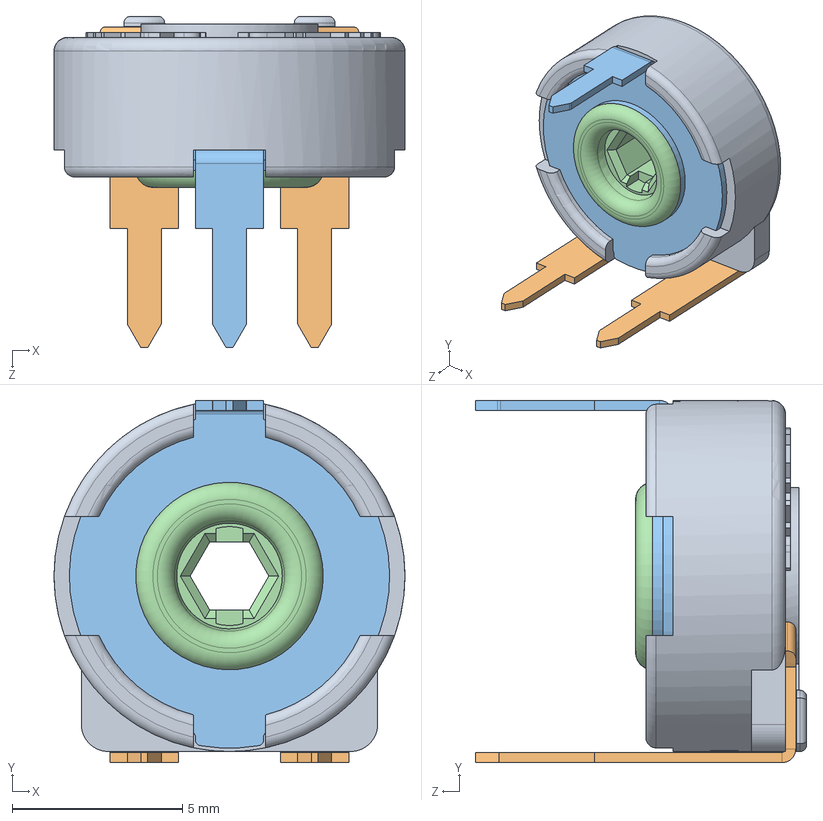
[picture p65: CAD file, 2024-05-27]
PCB/Rev. A/3D Models/9-PIHER_3D_PT10MV10.STEP
10.3 x 10.6 x 9.72 mm
PT10MV10-CARCASA
PT10MV10-TERMINAL DERECHO
PT10MV10-TERMINAL IZQUIERDO
PT10MV10-COLECTOR REBORDEADO
PT10MV10-PORTACURSOR_Predeterminada
