ArthurBondar/Tow-Camera-Public/(list of files, cad)

Other CAD files:
Model/Assemblies/Tow Camera v1 STL ASCII/4-Mid Attachment ASCII.stl
Model/Assemblies/Tow Camera v1 STEP/1-BackAttachment.step
Model/Assemblies/Tow Camera v1 STL ASCII/2-BattSpacer ASCII.stl
Model/Assemblies/Tow Camera v1.2/Platfrom.step
Model/Assemblies/Tow Camera v1.2/Protocase Order/Order 1 confimarmation files/BackFlange_x2 Rev(-).step
Model/Assemblies/Tow Camera v1 STEP/3-BattSupportCircle.step
Model/Assemblies/Tow Camera v1 STL ASCII/7-FrontAttachment ASCII.stl
Model/Assemblies/Tow Camera v1 STL ASCII/6-PiStandoff ASCII.stl
Model/Assemblies/Tow Camera v1.2/Platform.dwg
Model/Assemblies/Tow Camera v1.2/Protocase Order/Order 1 confimarmation files/Clamp_x2 Rev(-).step
PCB/Rev. A/3D Models/10-PIHER_3D_PT10LV10.STEP
Model/Assemblies/Tow Camera v1 STL/1-BackAttachment.stl
Model/Assemblies/Tow Camera v1 STL/2-BattSpacer.stl
Model/Assemblies/Tow Camera v1 STL/3-BattSupportCircle.stl
Model/Assemblies/Tow Camera v1 STL/4-Mid Attachment.stl
Model/Assemblies/Tow Camera v1 STL/5-Platform.stl
Model/Assemblies/Tow Camera v1 STL/6-PiStandoff.stl
Model/Assemblies/Tow Camera v1 STL/7-FrontAttachment.stl
Model/Assemblies/Tow Camera v1.1/STL/FlangePressBack.stl
Model/Assemblies/Tow Camera v1.1/STL/FlangePressFront.stl
Model/Assemblies/Tow Camera v1.1/STL/MiddleSupport-long.stl
Model/Assemblies/Tow Camera v1.1/STL/MiddleSupport.stl
Model/Assemblies/Tow Camera v1.1/STL/Part 1.stl
Model/Assemblies/Tow Camera v1.1/STL/Part 2.stl
Model/Assemblies/Tow Camera v1.1/STL/Part 3.stl
Model/Assemblies/Tow Camera v1.1/STL/Part 4.stl
Model/Assemblies/Tow Camera v1.1/STL/Part 5.stl
Model/Assemblies/Tow Camera v1.1/STL/PiCaseBody.stl
Model/Assemblies/Tow Camera v1.1/STL/PiCaseTop.stl
Model/Assemblies/Tow Camera v1.1/STL/PiStandoff.stl
Model/Assemblies/Tow Camera v1.1/STL/PlatformSupportLeft.stl
Model/Assemblies/Tow Camera v1.2/Frame_DXF_original/Platform(3).dxf
