ArthurBondar/Tow-Camera-Public/Documentation/Instructions/Images/Tow Camera v1.2 Render 1.png

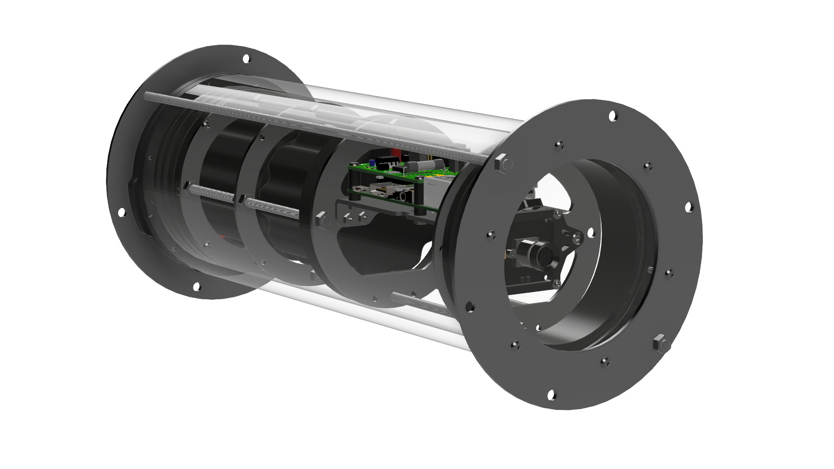
Documentation/Instructions/Images/Tow Camera v1.2 Render 1.png
