ArthurBondar/Tow-Camera-Public/Documentation/Instructions/Images/Tow Camera v1.2 Render 4.PNG

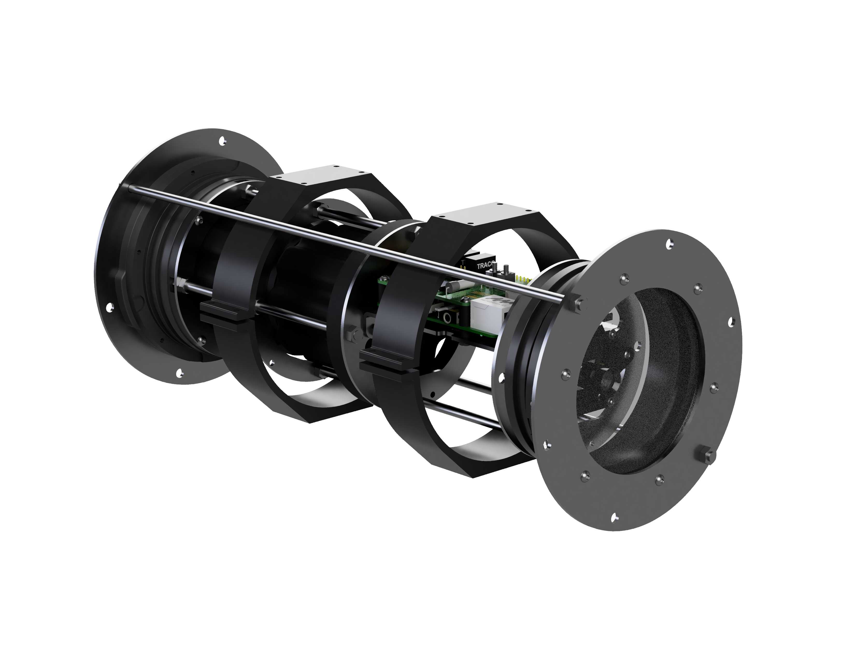
Documentation/Instructions/Images/Tow Camera v1.2 Render 4.PNG
