ArthurBondar/Tow-Camera-Public/Model/Assemblies/AquaTag 1.0 Assy v13.png

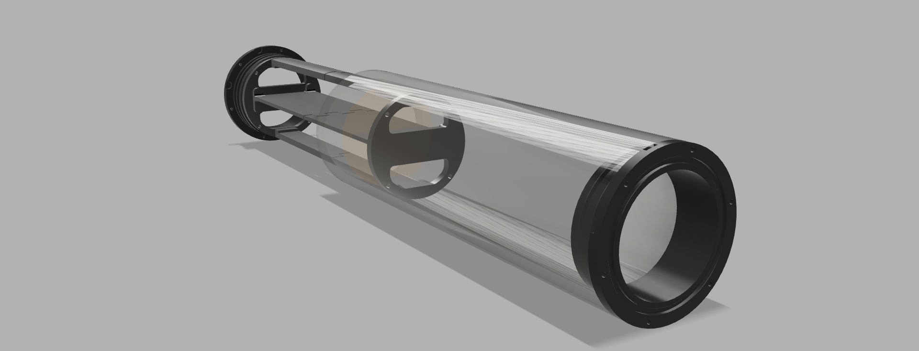
Model/Assemblies/AquaTag 1.0 Assy v13.png
