ArthurBondar/Tow-Camera-Public/Model/Assemblies/Tow Camera v1.0.PNG

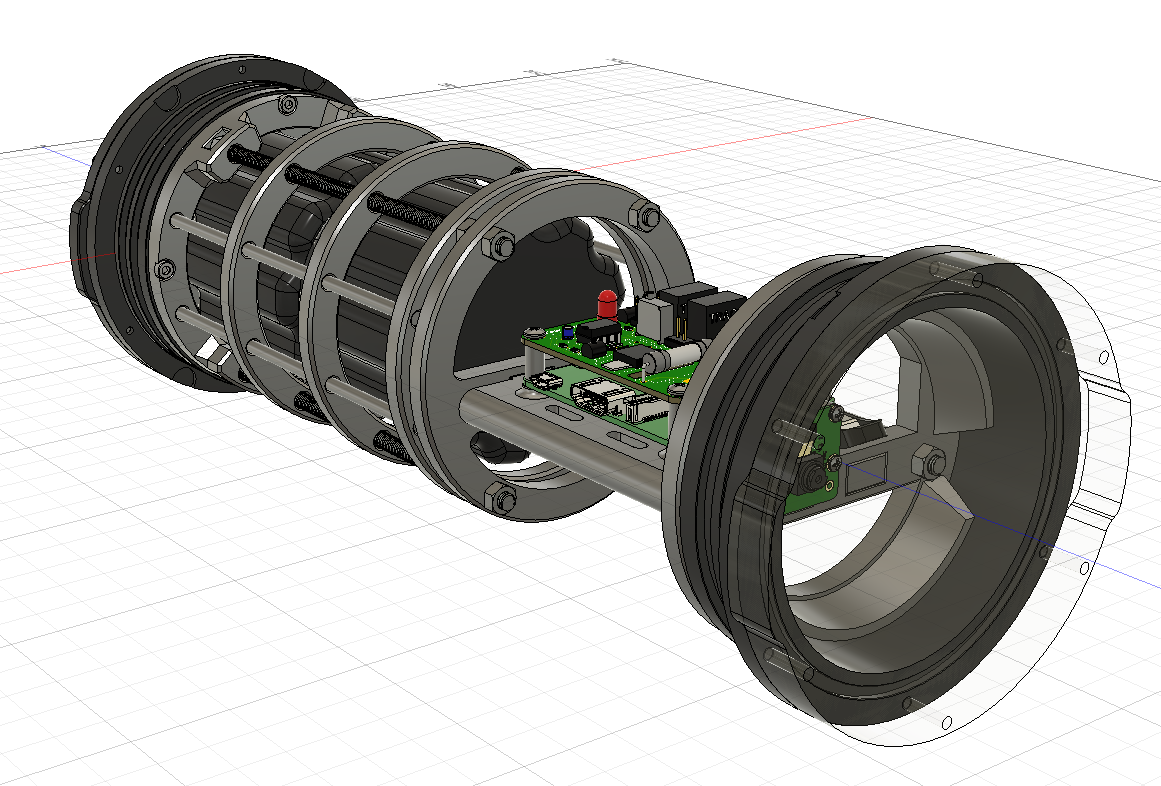
Model/Assemblies/Tow Camera v1.0.PNG
