ArthurBondar/Tow-Camera-Public/Documentation/4inch Assembly Drawing.pdf

114.3 [4.5in] 114.3 [4.5in] | 121.3 [4.78in] 298.45 [11.75in] | 335.85 [13.22in] 6 [.24in] Ø3.20mm | 12.7 [.5in]

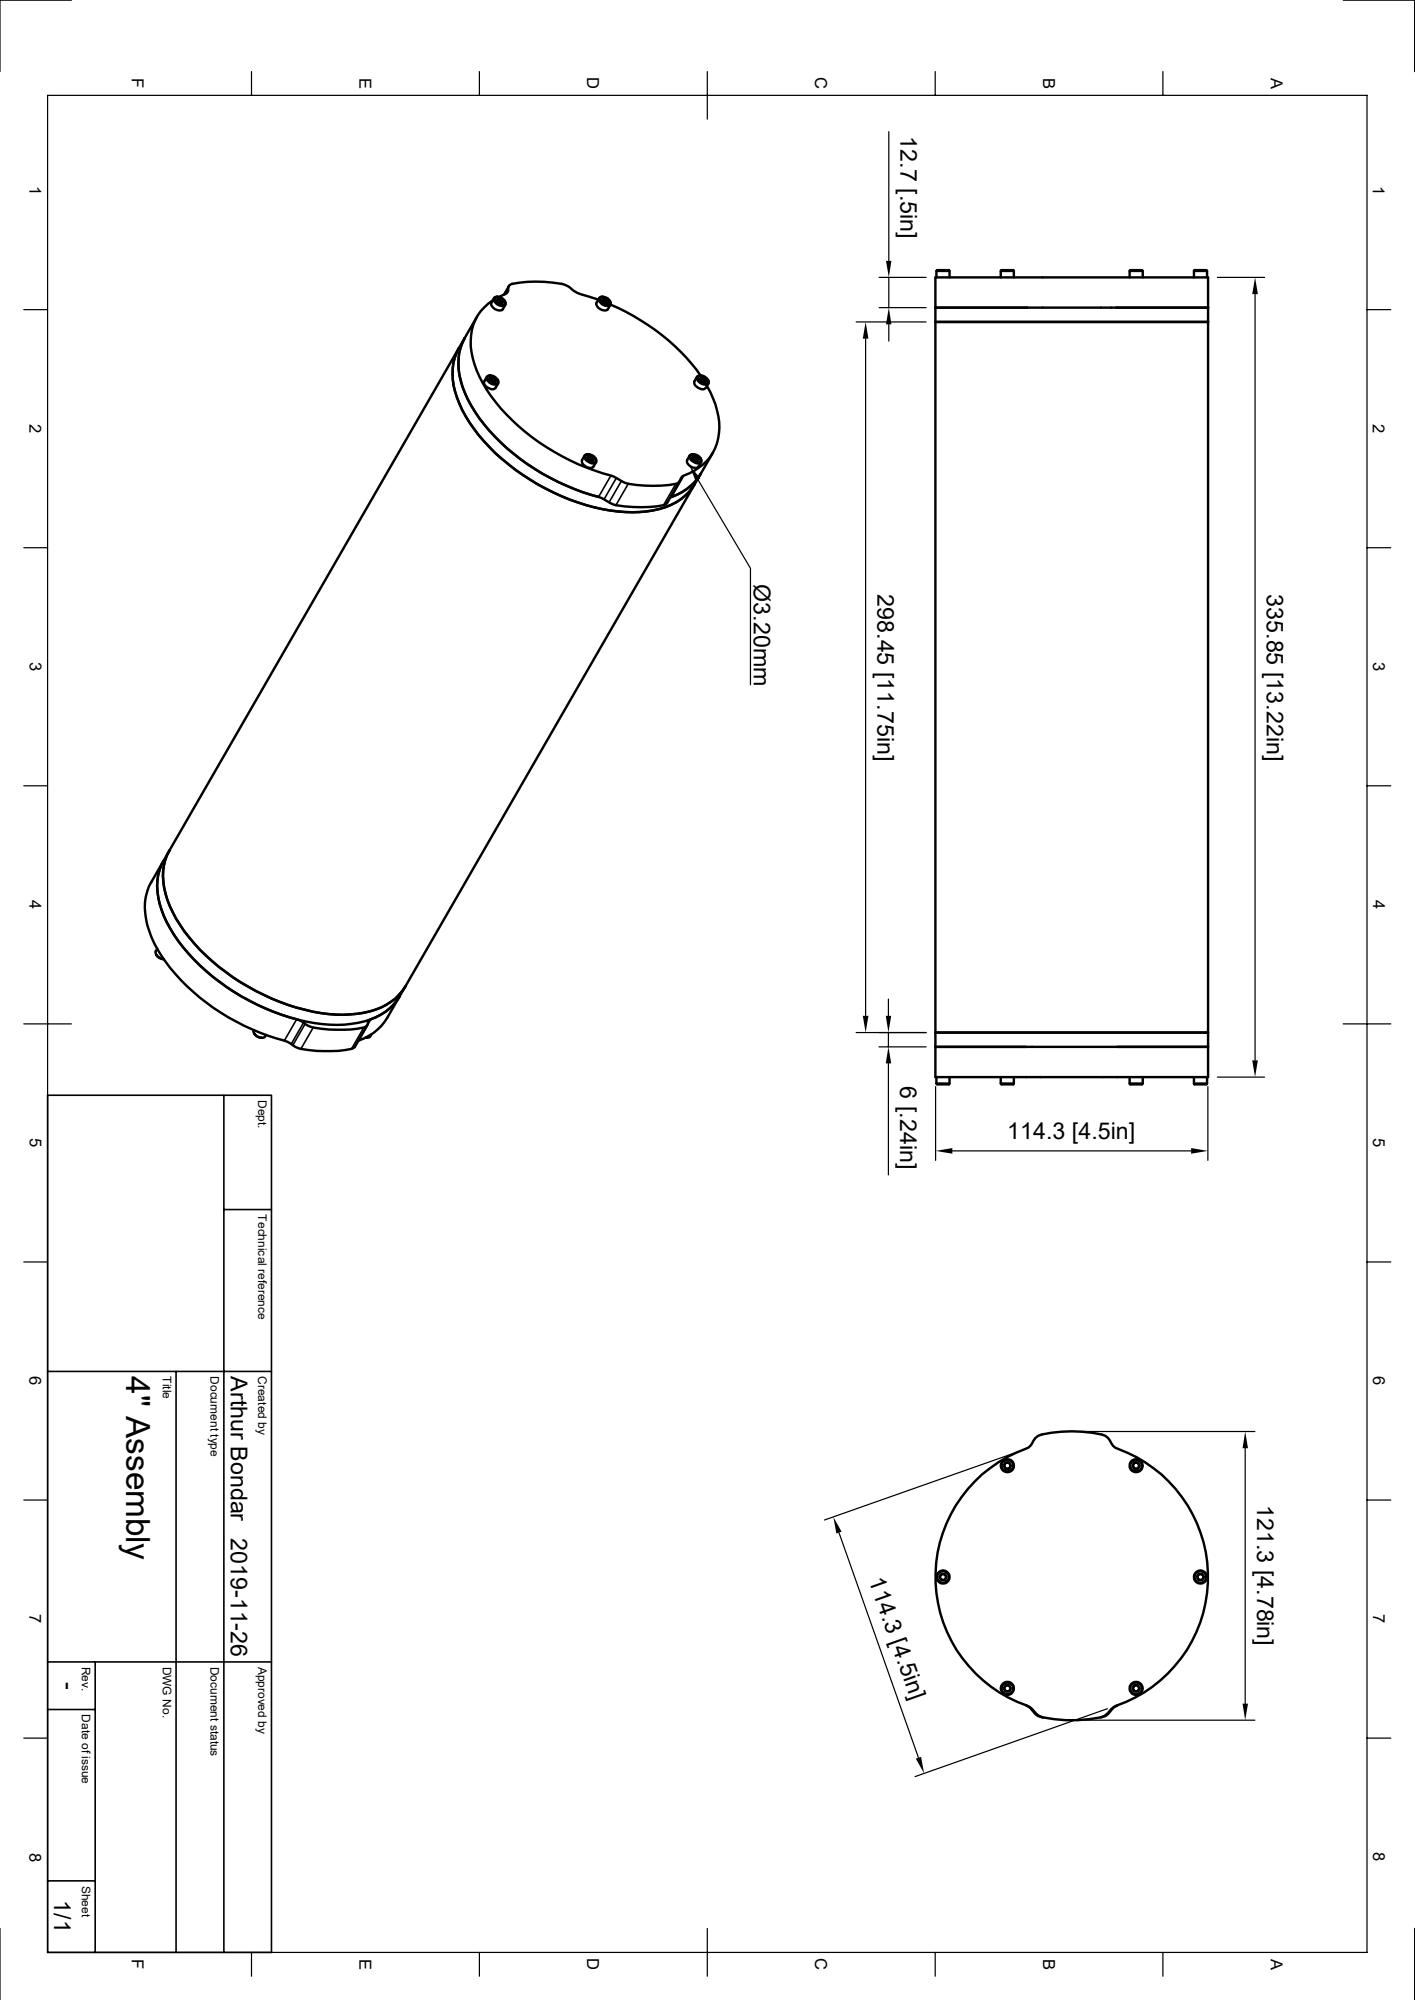
[picture p80: page 1]

1 A 2 3 4 5 6 7 8 1 2 3 4 5 6 7 8 FEDCB FEDCBA Dept. Technical reference Created by Approved by Title DWG No. Document type Document status Rev. Date of issue Sheet - 2019-11-26 1/1 4" Assembly Arthur Bondar
