ArthurBondar/Tow-Camera-Public/Documentation/4inch Bracket.pdf

30 [1.18in] | 40 [1.57in] M3x0.5 M4x0.7 5.5

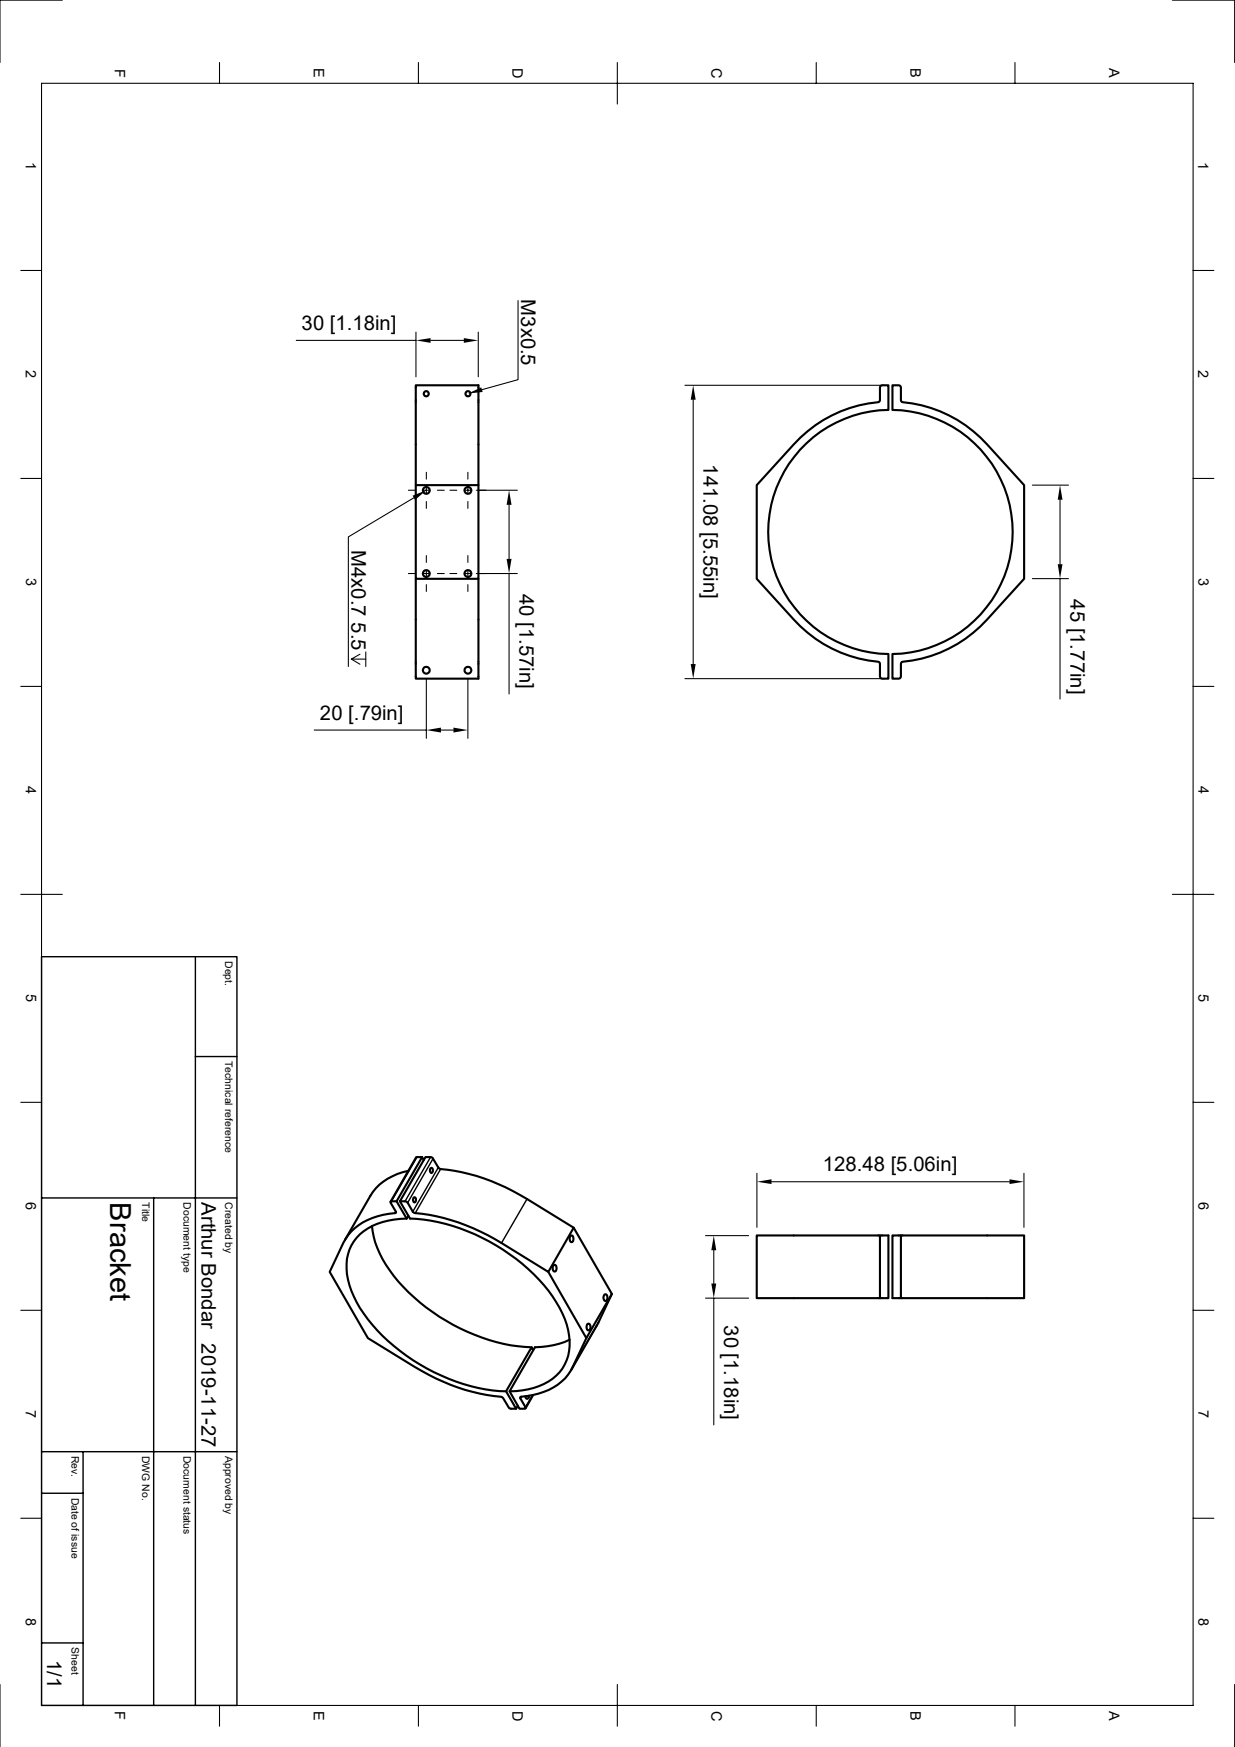
[picture p81: page 1]

1 A 2 3 4 5 6 7 8 1 2 3 4 5 6 7 8 FEDCB FEDCBA Dept. Technical reference Created by Approved by Title DWG No. Document type Document status Rev. Date of issue Sheet 2019-11-27 1/1 Bracket Arthur Bondar
128.48 [5.06in] ¹⁴¹.08 [5.55in] 30 [1.18in]
