ArthurBondar/Tow-Camera-Public/PCB/Rev. A/TowCam Rev. A.pdf

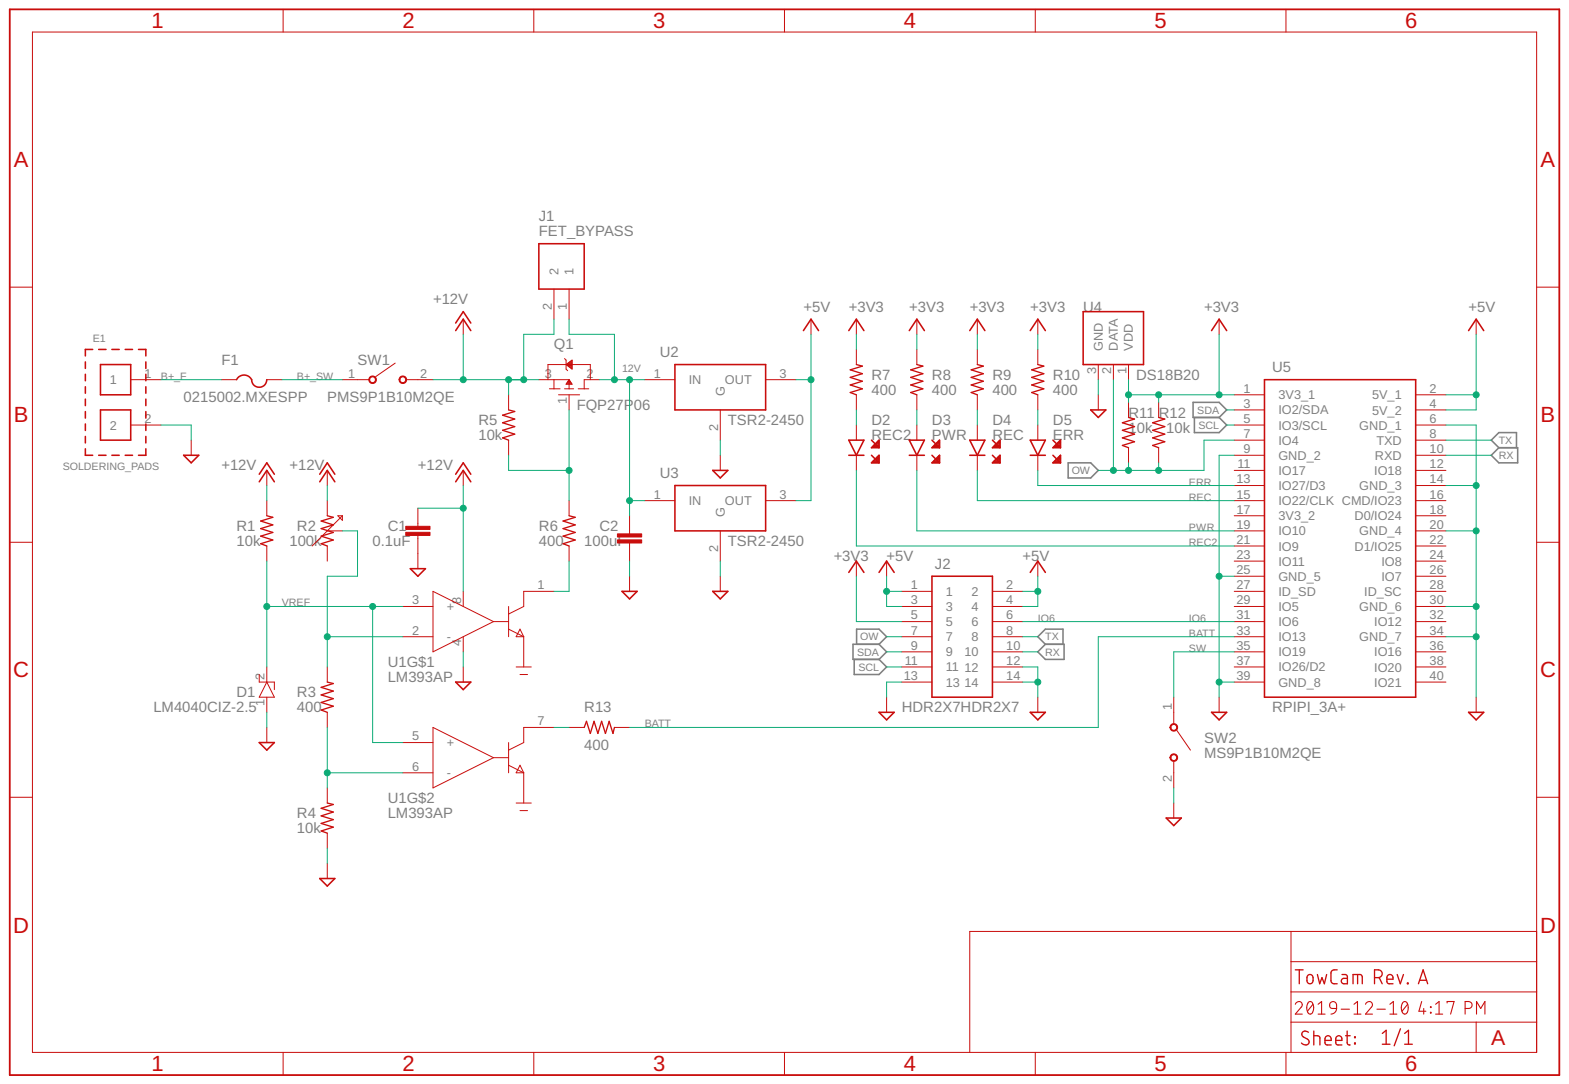
[picture p82: page 1]

33 | 34
35 | 36
