ArthurBondar/Tow-Camera-Public/PCB/Rev. A/TowCam Rev. A.brd

## EAGLE design PCB/Rev. A/TowCam Rev. A.brd (2024-05-27)

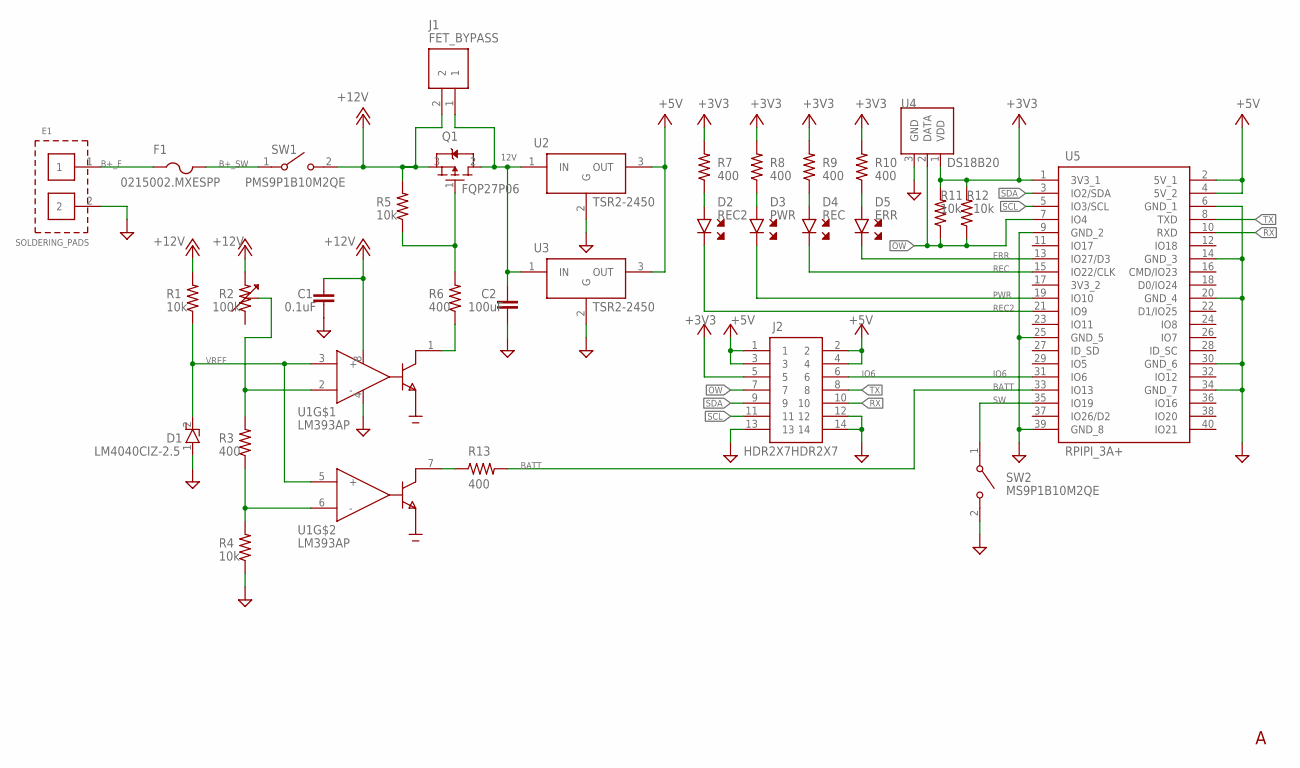
[picture p83: schematic TowCam Rev. A.sch]

Parts:
C1: 0.1uF; CAPPRD254W65D300H300B
C2: 100uF; CAP-TH-5MM
D1: LM4040CIZ-2.5; TO-92
D2: REC2; LEDRD254W60D565H860B
D3: PWR; R0805
D4: REC; R0805
D5: ERR; R0805
E1: SOLDERING_PADS
F1: 0215002.MXESPP
J1: FET_BYPASS; HDR1X2
J2: HDR2X7HDR2X7; HDR2X7
Q1: FQP27P06; TO-220-BEND
R1, R4, R5, R11, R12: 10k; R0805
R2: 100k; PV36W104C01B00
R3, R6, R7, R8, R9, R10, R13: 400; R0805
SW1: PMS9P1B10M2QE
SW2: MS9P1B10M2QE; PMS9P1B10M2QE
U1: LM393AP; DIP8
U2, U3: TSR2-2450
U4: DS18B20; TO-92
U5: RPIPI_3A+; PI_3A+

Connections:
12V: C2.1, J1.1, Q1.2 (D), U2.1 (IN), U3.1 (IN)
+3V3: J2.5, R7.2, R8.2, R9.2, R10.2, R11.2, R12.2, U4.1 (VDD), U5.1 (3V3_1)
+5V: J2.1, J2.2, J2.3, J2.4, U2.3 (OUT), U3.3 (OUT), U5.2 (5V_1), U5.4 (5V_2)
+12V: C1.1, J1.2, Q1.3 (S), R1.2, R2.3, R5.2, SW1.2, U1.8 (VCC)
B+_F: E1.1, F1.1
B+_SW: F1.2, SW1.1
BATT: R13.2, U5.33 (IO13)
ERR: D5.2, U5.13 (IO27/D3)
GATE: Q1.1 (G), R5.1, R6.2
GND: C1.2, C2.2, D1.1 (A), E1.2, J2.12, J2.13, J2.14, R4.1, SW2.2, U1.4 (GND), U2.2 (G), U3.2 (G), U4.3 (GND), U5.6 (GND_1), U5.9 (GND_2), U5.14 (GND_3), U5.20 (GND_4), U5.25 (GND_5), U5.30 (GND_6), U5.34 (GND_7), U5.39 (GND_8)
IO6: J2.6, U5.31 (IO6)
unnamed: R13.1, U1.7 (OUT)
unnamed: R2.2, R3.2, U1.2 (-)
unnamed: R3.1, R4.2, U1.6 (-)
unnamed: D2.1, R7.1
unnamed: R6.1, U1.1 (OUT)
unnamed: D3.1, R8.1
unnamed: D4.1, R9.1
unnamed: D5.1, R10.1
OW: J2.7, R11.1, R12.1, U4.2 (DATA), U5.7 (IO4)
PWR: D3.2, U5.19 (IO10)
REC: D4.2, U5.15 (IO22/CLK)
REC2: D2.2, U5.21 (IO9)
RX: J2.10, U5.10 (RXD)
SCL: J2.11, U5.5 (IO3/SCL)
SDA: J2.9, U5.3 (IO2/SDA)
SW: SW2.1, U5.35 (IO19)
TX: J2.8, U5.8 (TXD)
VREF: D1.2 (C), R1.1, U1.3 (+), U1.5 (+)

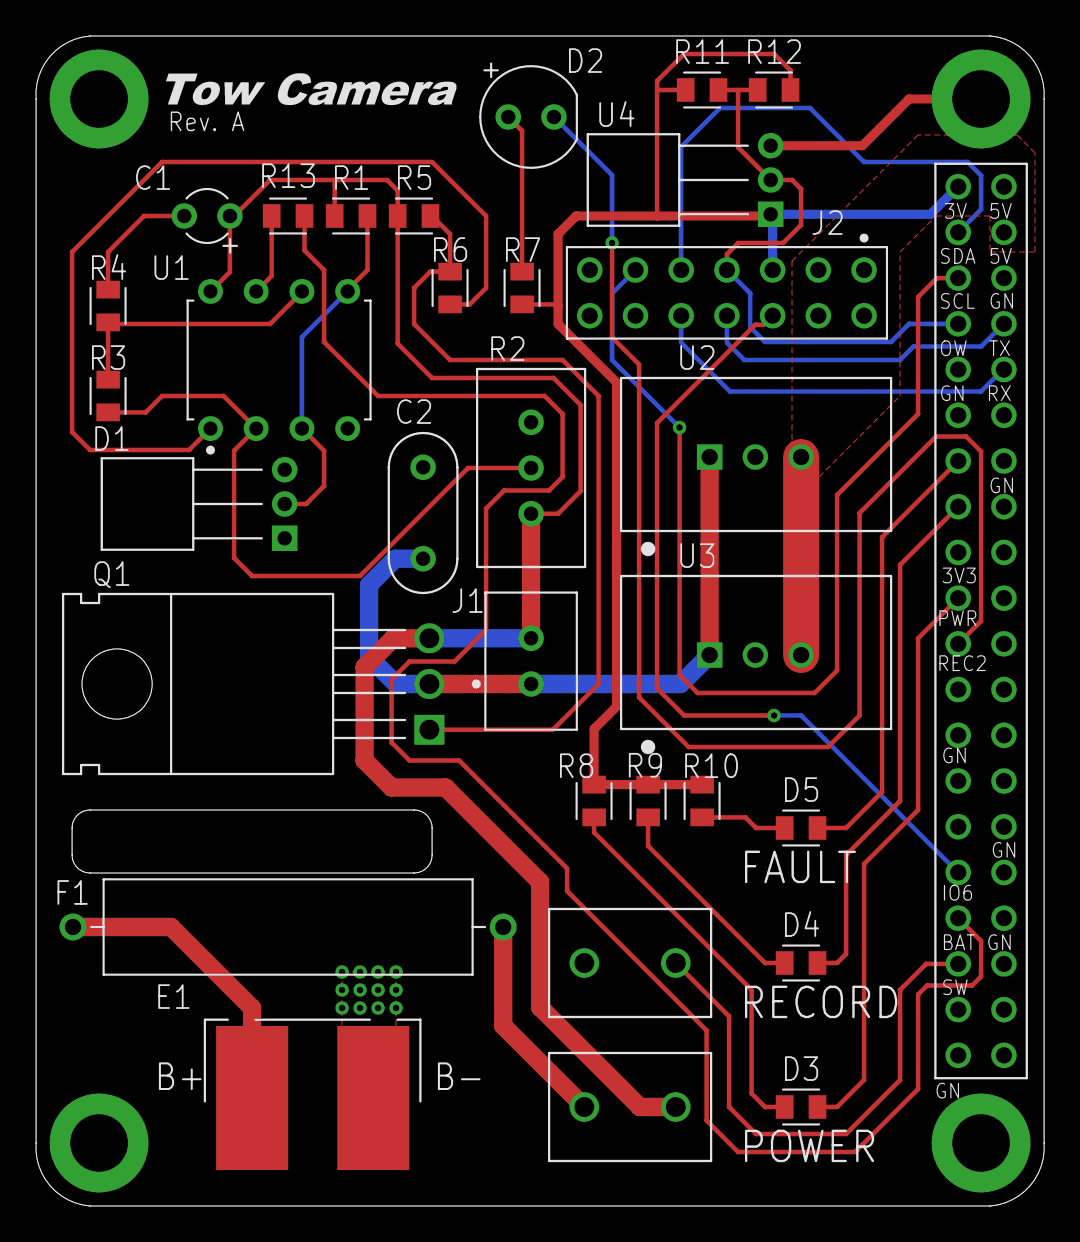
[picture p84: board TowCam Rev. A.brd from above]

Board: 2 copper layers, 56.0 x 65.0 mm, 32 parts (0 on the bottom side), 29 nets.
